Yara-5/DD2_Project_1/ai/mistakes_log.md

# AI mistakes log (overview, Appendix B)

| ID | Log entry | What was wrong | How you caught it | Would a weaker check have missed it? |
|---|---|---|---|---|
| M1 | U1 | The new `make check` piped the ngspice stress test through `tee`, so a stock ngspice (stress test exit 1) would still have passed `make check` | Re-reading the target: a pipeline's status is the last command's | Yes: on the fixed image the test passes either way, so only a stock build would show it |
| M2 | U1 | `transistor_level_check.py` passed the netlist and models as `DD2_Project_1/../student/...`; inside the container the repo is not mounted, so ngspice could not open them | `make sim` failed with "Could not find include file" | No: ngspice stops with a fatal error |
| M3 | U4 | The compact layout drew each signal pin shape flush with its 0.17 um li1 landing; Magic's resistance extraction starts a pin's net just outside the pin's lower-left corner, so it reported "Couldn't find wire" for A, B and Y and the RC netlist lost those nets' resistance | Tutorial 3's Magic error filter (the word "Error") made characterize.py stop on the generated nand2_1; LVS uses the same filter | Yes: a check that read only the netlist, without Magic's log, would have used an RC netlist with three nets unextracted |
| M4 | U4 | characterize.py ran six ngspice processes at once; the course ngspice evaluates BSIM4 with OpenMP threads set by its `num_threads` variable, not OMP_NUM_THREADS, so the runs oversubscribed the cores and a 20 s characterization took over 20 minutes | Load average 40 on 20 cores and 8 threads per ngspice (ps) | No check measures run time; fixed with `set num_threads=1` in every deck |
| M5 | U5 (review of fb7038d) | `src/netgen.sh` starts the container with `--entrypoint /usr/lib/netgen/tcl/netgenexec`; the course image (student pack `container/`) installs Netgen as `/usr/local/bin/netgen` and has no `/usr/lib/netgen`, so every LVS, RC-LVS and HD-LVS run fails (the script's own comment still describes the course image) | `make lvs`: all 18 cells `ERROR netgen exited with 127`; the log says `stat /usr/lib/netgen/tcl/netgenexec: no such file or directory` | Yes: `make test`'s LVS broken case (`nand2_1_wrong_width`) is still "rejected", only because Netgen never starts |
| M6 | U5 (review of fb7038d) | `euler.py` now looks the HD reference up in a fixed table `HD_SIGNAL_PINS` that leaves out nor3_1, so nor3_1 lost the `hd_reference` it had (its ports equal HD's), its LVS against HD and its Table 4 comparison | After `make layout`, `cells/dd2_g5__nor3_1/input.json` has no `hd_reference`; `make lvs` prints `HD-LVS=n/a` and `make compare` lists nor3_1 under `skipped_no_hd_reference` | Yes: no check requires a reference cell to have an HD reference; `compare_hd.py` skips such cells and still passes |
| M7 | U5 (review of fb7038d) | `verify_lvs.py` makes a cell fail unless LVS against the installed HD cell matches, and the change now gives a21o_1, mux2_1, a21oi_1 and o21ai_1 HD references. a21o_1 (12 transistors, HD 8) and mux2_1 (another topology) cannot match, and a21oi_1, o21ai_1 have the series order reversed (our PMOS B1 at VPWR, HD's at Y), which Netgen does not permute. `make lvs` fails for these four cells | `verify_lvs.py` run with the course-image Netgen wrapper (`--netgen`): LVS and RC-LVS match for 18/18, `HD-LVS=False` for the four, report `passed: false`, exit 1 | No: the check fails, once Netgen can run (M5 hid it) |
| M8 | U5 (review of fb7038d) | `hd_reference` maps the request's inputs to HD pin names by position (`zip(logical_inputs, hd_inputs)`) from a table keyed by the cell name, never from the function; it is right for the current requests only because they list inputs in HD order (mux2_1: A, B, C = A0, A1, S). `rename_layout_pins` is left commented out | Reading the diff; checked each mapping against the request's expression | Yes for the current requests; a request with its inputs in another order gets a wrong map and a false HD-LVS failure |
| M9 | U5 (review of fb7038d) | `validate_characterizer.py` (Table 5) is run by no `make` target, writes `results/characterizer_validation.json` outside `results/<check>/`, and its broken case (`characterize.py --index-by-ramp`) is not listed in `tests/broken/README.md` or run by `make test` (AGENTS.md rules 3 and 11); no stock-ngspice run exists, so the fixed/stock comparison of Table 5 has not been made | Reading the Makefile and `tests/broken/`; the checks were run by hand for this review | Yes: `make all` and `make test` pass without ever running the validation |
| M10 | U2 | `make network` pipes `synthesize.py` through `head -1`, so the shell sees `head`'s status and a crashed synthesis does not stop the loop | During this review's first `make layout`, `synthesize.py` raised `OSError` writing `cells/dd2_g5__maj4_1/network_schematic.png` (a locked file) and `make` went on to the next steps | Yes: the switch-level check that follows runs on whatever `network.json` is on disk |
| M11 | U6 | Fixing M7, `verify_lvs.py` was made to require LVS against HD only when the schematic is HD's circuit, so o21ai_1 (B1's PMOS 1.0 um, HD's 0.70 um) was only reported. Handout section 4.1 asks for the six reference cells "with the transistor sizes and pin names (A1, A2, B1 and so on) read from the installed cell's SPICE netlist", and Table 4 says the transistors "must match, including every W and L"; only a21o_1 and mux2_1 are report-only | Reading handout section 4.1 and Table 4 (U7) | Yes: `make test` passed with o21ai_1 reported |
| M12 | U5 | The review of fb7038d said there was no stock ngspice to run Table 5's simulator row with; Tutorial 3's image `dd2-layout-tools` has ngspice-42 (the handout names 42 as a stock build), and the course stress test fails on it (current ratio 1) | Listing the images and running `check_stress.sh` in each (U7) | Yes: `validate_characterizer.py` reported the stock build as NOT RUN, which is honest but was avoidable |
| M13 | U2 | The requests for handout Table 6 left out its last row, "One function of your choice" (17 functions plus inv_1 were in `tests/requests/`) | Re-reading Table 6 (U7) | Yes: no check counts the Table 6 requests |
| M14 | U7 | The first version of the disjoint decomposition in `synthesize.py` applied h's renaming of its internal nets to F's nets too, so F's stage `n1` became `x1_n1`, the name of one of h's stages: two stages drove one net in xor3_1. The built-in truth-table check passed, because it evaluates the stages in order and the second simply overwrote the first | The decomposition tree picture listed two stages `x1_n1` | Yes: the sanity check evaluated the function, not the connectivity; `synthesize.py` now refuses two stages on one net and nets shared between h and F |
| M15 | U7 | The rip-up-and-reroute router in `prepare_layout.py` checked a new via only against the fixed vias and, softly, other nets' vias: a net's own vias from its earlier connections, and two vias on one path, were never checked, so maj3_1 and xor3_1 got two vias of one net closer than mcon.2 allows (and overlapping cuts in xor3_1: mcon.1, li.1, met1.1) | `make test`: `verify_drc.py` failed every context of maj3_1 (2 errors, mcon.2) and xor3_1 (6-7 errors) | Yes: the cells were routed and drawn; only DRC stopped them. The router now treats the net's own vias as hard and repeats a search whose path puts two vias too close |
| M16 | U6 | Fixing M7, `euler.py` was made to pick the first placement whose circuit is exactly HD's (series order included). For nand2_1 and nand3_1 that placement does not route at HD's width, and `prepare_layout.py` widened it (a routing channel or an extra site) before trying the other placements, so both cells became one site wider than HD (4 and 5 sites); the README still said 3 and 4 | The Table 4 comparison of 6 November (`make reference`): `extra_sites: 1` for nand2_1 and nand3_1; the same in the 5 November log of U6 | Yes: width is a reported row of Table 4, so every check passed. `prepare_layout.py` now tries its attempts narrowest first; nand2_1 and nand3_1 are back to 3 and 4 sites with HD's series order |
| M17 | U7 | `compare_hd.py`'s new timing comparison required both cells to use the same table indices, but generated cells use HD nand2_1's indices and each installed cell its own, so the comparison raised an error as soon as a generated reference cell had been characterized | `make test` (`make reference`): `ValueError: ... use different table indices` | No: the check stopped with an error (exit 1). The generated tables are now interpolated bilinearly at the installed cell's points |
| M18 | U7 | Fixing M16, `prepare_layout.py`'s narrowest-first order put every attempt, li1 + met1 ones included, in one list sorted by width, so a multi-stage cell took a narrower route with met1 before a wider li1-only one: a21o_1 (5 sites, 6 vias) and and2_1 (4 sites, 6 vias) used met1 inside, and mux2_1 too. Handout Table 1 allows met1 in a multi-stage cell "only where li1 cannot route", and Table 4's wiring row ("li1 inside, met1 only for the rails") applies to a21o_1 and mux2_1 as well (only their transistor row is report-only) | `make test` (`make compare`): `met1_only_fixed_rails` failed for a21o_1 (0.6852 um2) and mux2_1 (0.4904 um2) | Yes: DRC, LVS and the simulations passed; only the Table 4 comparison stopped it. Every li1-only attempt (all widths, rip-up included) now comes before any li1 + met1 attempt; a21o_1 is li1-only at 6 sites (HD's width), and2_1 at 5 and mux2_1 at 10 (HD 9); the other 17 plans are unchanged |
| M19 | U8 | The first version of `liberty_view.py` required exactly one timing group per input, so the Liberty views of xor2_1, xor3_1 and mux2_1 (whose non-unate inputs have one positive_unate and one negative_unate group, as the HD Liberty writes xor2_1 and mux2_1's S) were rejected | Running the new check on all 20 characterized cells: `full_timing_tables` failed for xor3_1 ("A: 2 timing groups"); the HD Liberty then showed its own convention | No: the check rejected correct views; it now requires HD's two groups for a non-unate input and one group with the truth table's sense otherwise |
| M20 | U8 | `liberty_view.py` named its report `results/views/dd2_g5__<cell>.json` while `write_response.py` reads `results/views/<cell>.json`, as every other report is named | The first response of f14_1 said status "fail", reason "Liberty view: not run" | No: the response failed instead of passing; the report now uses the short name |
| M21 | U10 | The first met1 version of `folded_finger_nets_on_met1` started each new connection of a net from its li1 points only, so where the net's via already sat on a landing, the next connection put a second via an mcon pitch away, joined by an li1 jog (Y in nor3_stack_1: vias at 2.09 and 2.45 um) | The user, looking at the layout picture ("what are those two contacts in the middle?") | No check: the cell passed DRC, LVS and simulation; connections of the policy's nets now start from every point the net reaches, met1 included |
| M22 | U10 | Fixing M21, the record of the policy nets' met1 points was not reset between the router's net orders, so a later order branched from met1 wire that only an earlier order had laid; that attempt had the fewest vias and was kept, with Y and Y_u1 open | Reading the plan's routes before drawing: vias without met1 wire between them | Yes, before any check ran (LVS would have failed); the record is now cleared with the rest of each order's state |
| M23 | U12 | `multiply_cuts` (and `stack_contacts`) measured the gap between two diagonal shapes as the Euclidean distance, but Magic checks li.3 with square corners: a new licon column's li1 in a21oi_1 sat 0.07 um (x) and 0.16 um (y) from an A2 gate landing, 0.175 um diagonally, accepted | `verify_drc.py` on the sample: a21oi_1, 3 li.3 errors in each of its 24 contexts | Yes: DRC failed (exit 1); both functions now take the larger of the x and y gaps, as the router's rasters do; a21oi_1 then passed |
| M24 | U13 | The parallel defaults (JOBS 4 x INNER_JOBS 4 = 16 ngspice runs at once) were chosen from the core count, with memory named but not measured: 16 sky130 ngspice runs (about 0.4 GB each) do not fit in the 7.7 GB WSL memory | The full run of 10 November: the transistor-level step took 4 hours under swapping, and `make char` failed: f14_1 and f15_1 characterized 0 arcs (ngspice exit 137, killed by the kernel) | Yes: `characterize.py` exited non-zero and `make char` stopped (exit 2); measured 4, 8 and 16 runs at once (36 s, 40 s, 461 s) and set INNER_JOBS to 2 (8 at once) |
| M25 | U12 | `multiply_cuts` grew mcon arrays from every via in all four directions, adding li1 and met1 bars just to hold them: xor3_1 got three mcons in a row along x1's met1 wire and two along n1's, which carry next to no current and take room; and nothing kept other nets' met1 away from the pins (n1's met1 ran beside the Y pin), so a router placing the cell could not reach some pins on met1 | The group's review of xor3_1's preview on 11 November (no check covers either: DRC, LVS and the simulations passed) | No (caught by review): arrays now only along a stacked licon column; pin access pads reserved in the router and checked after planning (`check_pin_access`); 13 blocked pins in the five met1 cells, now none |
| M26 | U16 | `route_negotiated` let a wire end anywhere inside a fixed gate landing; in nor4_stack_1 two wires and their gate landings overlapped only corner to corner (0.09 x 0.09 um), a diagonal neck of 0.13 um, narrower than li.1 (0.17 um) | `verify_drc.py`: 2 li.1 errors in each of nor4_stack_1's 24 contexts; KLayout's width check placed both at the wire-landing corners | Yes: the planner's own checks measured spacing only, and LVS and the simulations do not see width; now a wire joins a fixed landing on its centre line, and `fill_notches` checks every merged net's width |
| M27 | U16-U19 | The scratch benchmark that plans many cells at once was meant to read regenerated layout specs from a folder named in ROOT, but the patch that added ROOT never applied (a shell heredoc handed Windows Python a path it could not open, and its error went unread). Every run that set ROOT planned the old specs from cells/ and build/stack instead: the same-gate placements of section 8.8 (xor2_1, xor3_1, nor4_stack_1) and the unsplit covers of section 8.7 were never planned, and the sizing run planned the x1 networks. The docs then credited the unsplit covers with a21oi_stack_1 and nand2_stack_1 losing their met1 (the wide landings did it) and said xor2_1's and xor3_1's new placements did not route (untested) | Reading the sizing run's output: it listed 27 cells planned, not the 8 under ROOT | Yes: every planned layout was legal and passed DRC and LVS, so no check could see that the wrong input had been planned; the benchmark now prints the spec folder of every cell and stops when ROOT matches none |
| M28 | U18-U20 | The cap on the negotiated router's failures per placement (2) assumed that a placement failing twice fails at every width; it was checked only on xor3_1, where it held. nor4_stack_1 and o21ai_stack_1 succeed on their third negotiated attempt or later, at another routing channel, so with the cap they came out 11 sites, and 10 sites with met1, instead of 10 and 8 on li1 | The all-cell planner benchmark of the runtime changes, compared cell by cell with the latest known results | Yes: both layouts were legal, so DRC and LVS would have passed them; only comparing widths and vias with earlier runs showed the loss. The cap was removed |
| M29 | U19 | The opt sizing searched internal widths from channel_min_width (0.36 um), taken for the smallest legal transistor. The installed sky130A.tech checks standard FETs against 0.42 um (diff/tap.2, allfetsstd) and extracts any narrower one as sky130_fd_pr__special_nfet_01v8 / special_pfet_01v8_hvt; 0.36 um applies only to those special devices. mux2_opt_1 (input inverter 0.36/0.36 um) and xor3_opt_1 (two stages at 0.36 um) were extracted with special devices that the schematic does not have | verify_lvs.py in the three-family run of 10 November: LVS and RC-LVS failed on both (device classes differ); Netgen's report named the special FETs | No: LVS caught it. Fixed with a rule fet_min_width (0.42, proven by make check against line 4771 of sky130A.tech) as the opt minimum |
| M30 | U20-U22 | The final three-family run chained `make test_views` after the checks, assuming that its prerequisites (roundtrip, views) pulled in characterization; `views` has no prerequisite on `char` (the order is documented, not enforced), so characterization never ran and the Liberty views were built from characterized.json files written before the layouts changed | `liberty_view.py` in that run: a21oi_1 failed `area_is_the_layout` (stale characterization, old area) and the new stack and opt cells stopped on a missing characterized.json; `make views` exited 2 | No: the check refused stale and missing data, so nothing wrong was written; the run was restarted as `make char views roundtrip test_views` in that order |
| M31 | U24 | To check the merged Makefile, `make -n check` was run in the repository itself. A dry run still executes every recipe line that contains `$(MAKE)`, and Yara's stress-test line did (its rebuild branch), so the stress test ran with the Windows-path mount and wrote Docker's error to results/check/ngspice_stress.log; the broken log was committed in 97afe2d | `liberty_view.py` in the first `make demo` runs: "the ngspice stress test did not pass" for both cells | No: the views check refused the log, so no Liberty view was written from it; `make check` (fixed) regenerated it, identical to the full run's log (ngspice-47, SHA 51123371..., ratio 1.035) |
