Yara-5/DD2_Project_1/ai/use_log.md

# AI use log (overview, Appendix B)

Every session ran in Claude Code on Youssef's PC, which the group shared, so the assistant's environment always shows Youssef. **Who** names the member whose part the session worked on: Youssef Ayman Hassan the synthesizer and layout optimizations, Hassan Ashraf the Euler paths and routing, Yara Abdelkader the characterizer, the request reader and testing. A session that touched more than one part names each owner.

| ID | Date | Who | Tool and model | What you asked | What you kept or changed | How you checked it | Commit |
|---|---|---|---|---|---|---|---|
| U25 | 2026-11-11 | Yara | Claude Code, Claude Opus 5.5 | "fix the issues with the demo" | Makefile `demo` rewritten as `demo` + `demo-cell`: every file goes to build/demo/ (cells/<name>/, results/<check>/), so a demo no longer overwrites the committed cells/ and results/; the transistor-level check reads the netlist verify_lvs.py just extracted (before, cells/<name>/ held none for a new cell, or an old one); synthesize.py gets --hd-liberty (opt sizing); characterization runs only when Table 5 has passed and the stress log exists; the HD comparison and the round trip are added. src/request_reader.py: the request is no longer renamed after its file (Yara's cb80672); its own "name" is validated as before, so the GUI's request_raw.json no longer becomes dd2_g5__request_raw. A refused request still gets a fail response; the demo now exits non-zero for it. The HD comparison runs only for a request with an installed HD counterpart (compare_hd.py fails with no cell to compare) | `make demo` on a new function from a file named differently (build/demo_input/interview_request.json, name dd2_g5__o21a_1): every step passed, response "pass" (2 stages, 8 transistors, 6 sites, DRC 0 in 24 contexts, LVS and RC-LVS match), round trip equivalent, exit 0 in 201 s; on tests/requests/nand2_1.json: every step including LVS against HD and the HD comparison, exit 0; on tests/broken/bad_request.json: fail response with the reader's reason, exit 2; git status showed no change under cells/ or results/ from any demo | (uncommitted) |
| U24 | 2026-11-11 | Yara | Claude Code, Claude Opus 5.5 | "I want you to verify that the portability stuff are working properly", then "Yes, fix them" | Makefile (`make check`, `docker-stock-image`), on top of cb80672: the HD Liberty is tested at its host path (HD_LIB_HOST); the tool checks run `command -v` inside `sh -c`, since `wsl -e` starts programs only; the stress test folder is mounted by its Linux path; after a stock ngspice (check_stress.sh exit 1) is rebuilt, the second run is written to results/check/ngspice_stress.log and sets the exit status (before, the log kept the stock FAIL while make check passed); the stock image is built as ngspice 42, Tutorial 3's stock version, not an unpatched 47. No check got weaker; the stress test itself is unchanged | In a worktree of main on Windows + WSL: unfixed, `make check` failed on the HD_LIB test, the tool tests and the Docker mount; fixed, `make check` exit 0 (stress PASS, ngspice-47); `make check IMAGE=<copy of Tutorial 3's stock image>` detected ngspice-42 (FAIL), rebuilt the image, retested it (PASS, ngspice-47) and wrote that second run to the log, exit 0; `make docker-stock-image` built ngspice-42, whose stress test reports stock (exit 1). Table 5 was not rerun with the newly built stock image | (uncommitted) |
| U23 | 2026-11-11 | Yara, Youssef | Claude Code, Claude Opus 5.5 | "run the whole flow for the 3 families" (finished), then "Yes, update docs" after the opt cells were characterized | Ran the three-family flow on 33 cells (xor3_opt_1 held out on "Drop it, run the rest"); README results and limitations and docs/TECHNICAL.md 7.1, 19.2-19.3, 20 rewritten from the result files: opt measured against hd (maj4 -5.3 %, and2 +34.4 %), so the Elmore model's predicted gains are reported as not confirmed | `make drc lvs compare sim model`, `make -o all test`, `make char`, `make views`, `make roundtrip`, `make test_views`: all exit 0 (logs build/full_nov10e, build/full_nov10f); every number in the docs read from results/ and cells/ | (uncommitted) |
| U21 | 2026-11-10 | Yara | Claude Code, Claude Opus 5.5 | "Let's speed-up the transistor-level check. It's insane if it's 4 hours." Check script changed on this explicit request (AGENTS.md rule 9) | src/transistor_level_check.py: every DC row and every edge becomes its own copy of the cell (own sources, own load, sharing only the ideal supply) in one netlist; the copies run in --jobs decks, one ngspice run each (op for the DC rows, tran for the edges), instead of one ngspice run per case. Cases, transient timing, thresholds and verdict code unchanged (not weaker); docs/TECHNICAL.md 12.2, README | Against the 10 November reports on the same netlists, case by case: nand2_1, a22oi_1, xor3_1 identical verdicts, DC voltages and worst glitches (0.000 uV / 0.000 mV apart), 20-28 s per cell; broken case nand2_1_pex_missing_pullup still rejected (exit 1) on the same DC row and the same 3 edges; a missing model file still fails (exit 1); original kept in build/ for the comparison | (uncommitted) |
| U20 | 2026-11-10 | Hassan | Claude Code, Claude Opus 5.5 | "how can we address 7" (runtime), "let's go", then "make the call now, we don't have time really" | prepare_layout.py: rip-up skipped in the li1-only attempts when the negotiated router runs (policy rip_up_with_negotiated, false); quick check that routes every net alone with movable contacts before an li1-only attempt (policy lone_net_check, `route_negotiated(first_pass_only=True)`); the per-placement cap on negotiated failures (added the same day for xor3_1) removed; rules.json, docs/TECHNICAL.md 9.6, README limitations | Planner-only re-plan of all 27 cells: 25 unchanged and the met1 cells 2-3x faster; nor4_stack_1 and o21ai_stack_1 regressed, traced to the cap (mistakes log M28); re-planned without it, both back to 10 and 8 sites on li1; xor3_1 not re-timed without the cap; no DRC or LVS needed for unchanged layouts | (uncommitted) |
| U19 | 2026-11-10 | Youssef | Claude Code, Claude Opus 5.5 | "Do option 2, we're going all in" (a sizing method of our own), then "Document this sizing method and explain the elmore delay estimation in the technical.md" | synthesize.py: `inverter_model` (RC per um fitted to HD inv_1's Liberty), `worst_delay` (Elmore, every pin, edge and route), `size_internal_stages` (coordinate descent over internal stage widths), `--hd-liberty`, `--rules`; rules.json policy internal_stage_sizing; docs/TECHNICAL.md 7.1, README item 10. The Makefile is unchanged: the handout's hd and stack ways keep inner stages x1, so the method is an optional third way until the group decides | Model widths and predicted delays for 8 multi-stage cells (network.json in build/size); switch-level check PASS on all 8; widths in sites unchanged; verify_drc on all 8 in build/sizechk and build/sizechk2: 192 contexts 0 errors, control caught, layer check PASS; no characterization yet (planned for the end of the day), so the gains are predictions | (uncommitted) |
| U18 | 2026-11-10 | Hassan | Claude Code, Claude Opus 5.5 | "next weakness" (pins for place and route), then "undo this. I think it's not necessary. Go and consider weakness 4" (folded layouts) | Pin patches on met1 tracks (planned, sampled with DRC and LVS) removed again at the group's request: nothing of them is left in src/ or rules.json. euler.py: `finger_cover(unsplit_first)`, `stage_options` keeps the two best covers with the fewest split leaves, `build_layout_spec` accepts any placement with the same devices as an alternative; docs/TECHNICAL.md 8.7 and 9.8, README item 9 | All 27 specs regenerated: first placements and devices unchanged; a first planner benchmark meant to use them planned the old specs (mistakes log M27): its a21oi_stack_1 and nand2_stack_1 gains (li1 only) came from U17's wide landings. Re-planned from the regenerated specs: a22oi_stack_1 13 sites and 9 vias -> 10 sites li1 only (build/chk5: DRC 24 contexts 0 errors, layer check, LVS and RC-LVS match), xor3_1 16 -> 14 sites (13 vias), xor2_1, nor4_stack_1, nand3_stack_1, nor3_stack_1, o21ai_1 unchanged; policy negotiation_failures_per_placement added (xor3_1 over 40 CPU minutes -> about 14 minutes), removed again in U20 (mistakes log M28); in build/chk4 verify_drc: 48 contexts 0 errors, control caught, layer check PASS; verify_lvs: LVS and RC-LVS match; transistor-level check not run; cells/ and results/ not rebuilt | (uncommitted) |
| U17 | 2026-11-10 | Hassan | Claude Code, Claude Opus 5.5 | "let's consider the second weakness now" (cells wider than HD) | prepare_layout.py `route_negotiated`: a movable contact's landing may be wide (0.33 x 0.17 um) as well as tall, whichever is legal and less crowded; docs/TECHNICAL.md 9.5e and 9.8, README item 7 and limitations | Widths against HD's prBoundary and against each cell's narrowest placement (every extra site came from routing); planner benchmark of the 13 cells whose routing cost width: o22ai_1 7 -> 5, nand3_stack_1 15 -> 10 and o21ai_stack_1 10 -> 8 without met1, nor4_stack_1 10, a21oi_1 4, eight unchanged; in build/chk2 verify_drc: 120 contexts 0 errors, control caught, layer check PASS, 20 broken layer copies rejected; verify_lvs: LVS and RC-LVS match on all five, LVS against HD a21oi_1 match; transistor-level check not run; cells/ and results/ not rebuilt | (uncommitted) |
| U16 | 2026-11-10 | Hassan | Claude Code, Claude Opus 5.5 | "List the weaknesses we have now... We want to highly improve this cell generator", then "Yes, router first", "I don't want you to re-run the whole flow after improving each weakness... choose only what's absolutely necessary", "let's document this behavior" | prepare_layout.py: `route_negotiated` (li1 router with negotiated congestion that places the signal diffusion contacts; tried after the fixed-landing router at each li1-only width), `plan_geometry(movable=)`, output pin placed after routing, `gate_runs(any_gate=)`, width check in `fill_notches`; euler.py `place_stages` keeps up to 8 more placements with adjacent same-gate columns; rules.json policies negotiated_router, negotiation_*, poly_bars_same_gate (all on); docs/TECHNICAL.md 8.8, 9.4, 9.5e, 9.6, 9.8, README items 7-8 and limitations | Planner benchmark of all 27 cells (20 requests and 7 stack cells) in build/, no simulation: a21oi_1 5 -> 4 sites, nor4_stack_1 5 vias -> li1 only at 11 sites, 25 unchanged; DRC in build/chk failed first on nor4_stack_1 (li.1, M26), then after the fix: 48 contexts 0 errors, control caught, layer check PASS, LVS and RC-LVS match, LVS against HD a21oi_1 match; transistor-level check not run; cells/ and results/ not rebuilt | (uncommitted) |
| U15 | 2026-11-11 | Youssef, Hassan | Claude Code, Claude Opus 5.5 | "having 3 mcons horizontal like what we have on the top left here is meaningless. Same for the two below. Also there is a metal1 wire passing too close to the Y pin. These pins will need to access met1 later (Y pin and input pins)" (on xor3_1's preview) | prepare_layout.py: `via_pad`, `pin_access_pads`, `check_pin_access`, `square_gap`; router treats each signal pin's met1 access pad as met1 of its net; planner tries every pin reachable, then one pin per port, per attempt; output pin on the first landing whose pad clears the rails; `multiply_cuts` mcon arrays only along the licon column a via is stacked on (spanning the via, no li1 added, met1 bar clear of other nets and pin pads); rules.json policy pin_access_met1 (true), description; docs/TECHNICAL.md 9.5c, 9.5d, 9.8, README | Five met1 cells re-planned in build/pa: pins blocked 13 of 32 -> 0; arrays none (no room beside any stacked column); maj3_1 10 -> 12 sites, maj4n_1 7 -> 10, maj4_1, xor2_1, xor3_1 unchanged; verify_drc: 120 contexts 0 errors, control caught, layer check PASS; verify_lvs: LVS and RC-LVS match, isolated DRC unchanged (tap rules only); transistor_level_check PASS for all five (DC and every single-input edge); the other 15 cells re-planned in build/pa15: shapes identical to cells/ | (uncommitted) |
| U14 | 2026-11-10 | Yara | Claude Code, Claude Opus 5.5 | "After that run the whole flow with the current optimizations and review the results" (same request as U13) | Makefile: per-cell steps run again on a Windows file lock (Errno 22 or 13 only, 3 tries, logged in build/logs/); INNER_JOBS 4 -> 2 after the run (M24); README sections 3, 5, 6, 9 and docs/TECHNICAL.md 2.4, 19.2-19.4, 20 updated from the run's files; a stray results/transistor_level/nonexistent.json (from testing the retry) deleted (rule 11) | make check exit 0 (4 s); make test exit 0 (4 h 22 min: every check passes for all 20 cells, all 10 broken cases rejected); make char at 16 ngspice runs at once exit 2 (f14_1, f15_1 killed out of memory); measured 4/8/16 runs at once (36/40/461 s), INNER_JOBS 2; make char exit 0 (45.6 min, memory peak 6.9 GB of 7.7), make test_views exit 0 (1.9 min, one file-lock retry, views-nand2_1). Review: 130 sites (138), 348 diffusion licons (190), 37 vias (60), summed R -10 to -47 %, C +3.6 to +17 % (two narrower cells lower), median delay -3.9 to +0.4 %; HD timing within 2.9 % for the seven single-stage cells, a21o_1 +5.3 % (+10.2 %); NOR3 stack 2.5 x area (3.75 x) | (uncommitted) |
| U13 | 2026-11-10 | Yara | Claude Code, Claude Opus 5.5 | "When you finish this, parallelize the flow, document the decisions you make, I will not be available to answer them. After that run the whole flow with the current optimizations and review the results." Check scripts changed on this explicit request (the earlier proposal named verify_drc.py, verify_lvs.py and the simulation scripts; AGENTS.md rule 9): only how they run, not what they check | Makefile: JOBS (4) and INNER_JOBS (4); per-cell targets network-, layout-, sim-, model-, charhd-, char-, views- run by a sub-make -j$(JOBS) -Otarget; drc, lvs and reference pass --jobs; magic_drc_runner.py and verify_drc.py: --jobs, DRC contexts on a worker pool, results in manifest order; verify_lvs.py: --jobs, cells on a worker pool, results in name order; README, docs/TECHNICAL.md 2.4 (the five decisions) | verify_drc.py --jobs 4 on a21oi_1 (24 contexts, 12 s): every field equal to the serial report but the context GDS hashes (time-stamped by KLayout on every run); verify_lvs.py --jobs 4 on five cells: report identical; make layout on inv_1, nand2_1, a21oi_1 in parallel (9 s): same shapes as the serial runs. The full make test / make char / make test_views follows (row U14) | (uncommitted) |
| U12 | 2026-11-10 | Youssef | Claude Code, Claude Opus 5.5 | "whenever we place licon, maximize the number of licons placed in parallel... Similarly, when you place the met1 vias, maximize their number"; answers asked for: fill after routing; signal and supply diffusion contacts and met1 vias (not gate contacts); arrays at each via point; verify a sample now | rules.json: licon_space (0.17, licon.2, proven by `make check`: 30 rules), policies multiple_licons and mcon_arrays (default true); prepare_layout.py: multiply_cuts (largest licon column per diffusion contact, narrow or wide li1 bar; mcon arrays grown breadth first), supply contacts record their y range, square-corner spacing in multiply_cuts and stack_contacts (M23); docs/TECHNICAL.md 9.5c, 9.8, README | Sample in build/mc, build/mc3: inv_1, nand2_1, a21oi_1, maj3_1, xor3_1 re-planned (widths unchanged; licons 4->9, 5->12, 7->13, 14->26, 22->45; mcons 9->10, 10->14); verify_drc: four cells 0 errors, a21oi_1 72 (li.3, M23), after the fix 0, control caught, layer check PASS; verify_lvs: LVS, RC-LVS and HD-LVS match; transistor_level_check PASS for all five; extracted R -9.5 to -27.8 %, C +7 to +17 % | (uncommitted) |
| U11 | 2026-11-10 | Youssef | Claude Code, Claude Opus 5.5 | "In general, I want to minimize the length of the path that uses li1 if it is going to connect to met1 anyway. I want the contact and via to be aligned directly on top of each other whenever possible... Don't forget to document all the optimizations we'll do in this session." | prepare_layout.py: stack_contacts (a diffusion contact joined to a via of its net by one straight vertical li1 stub moves under the via when its licon.5c range and li.3 allow; contacts record y_range_um and landing_box), policy stack_contacts_under_vias (default true); a connection that needs met1 pays met1_route_li1_step_cost (100, replaces folded_finger_li1_step_cost) per li1 step and may start from the net's met1 wire (multi-source search), for every net, not only the policy's; rules.json: the two policies; cells/ of maj3_1, maj4_1, maj4n_1, xor2_1, xor3_1 replaced by the checked layouts; README (Layout optimizations, Limitations), docs/TECHNICAL.md 9.5, 9.5a, 9.5b, 9.8, 19.3 | Re-planned the six cells with vias (build/stack_try2): vias on a contact 6 -> 37 of 46, li1 in met1-carrying nets -37 % to -82 %, maj3_1 12 -> 9 vias, xor3_1 14 -> 10, maj4n_1 10 -> 7 sites. In build/verify_stack: verify_drc 144 contexts 0 errors, control caught, layer check PASS; verify_lvs LVS and RC-LVS match for all six; transistor_level_check PASS for all six. Signal-net R (sum of extracted resistors) -1.0 % to -8.1 %, C -3.1 % to +11.6 %. Not run: the full flow; the six cells' reports in results/, their characterization, views and responses are still those of the 6-7 November layouts | (uncommitted) |
| U10 | 2026-11-10 | Youssef, Hassan | Claude Code, Claude Opus 5.5 | "For the transistor folding... connect the polys directly without using li1 or met1. Try doing this. Do not run the whole flow, only what's essential"; clarified: "you only need to extend the spacing between consecutive polys to space out the transistors"; then: route folded fingers' nets on met1 instead of li1, chosen as a switchable policy (asked, because handout Tables 1 and 3 keep met1 for the rails in single-stage cells) | euler.py: finger_cover prefers each leaf's fingers side by side (new cost term after width), so the narrower row's gates spread out under their fingers; prepare_layout.py: gate_runs, one poly bar per run in the npc band with one contact, no pad or li1 bound for contact-less fingers (pitch 0.42 um); policy folded_finger_nets_on_met1 (rules.json, default false) with folded_finger_li1_step_cost, multi-source search from the net's met1 wire, `--policy NAME=JSON` override; docs/TECHNICAL.md sections 8.7, 9.4, 9.5, 19, 20, README | Local work stashed (stash@{0}) and `git pull`: origin had nothing new. Only nor3_stack_1 rebuilt (cells/): euler.py, switch level PASS, prepare_layout (1 s, was 1226 s), generate_gds: 10 sites (was 15), 0 vias (was 16), 3 gate contacts (was 9); in build/stack_only: verify_drc 24 contexts 0 errors, control caught, layer check PASS; verify_lvs LVS and RC-LVS match; transistor level 8 DC rows, 24 edges PASS. Re-planned nand2_1, a21oi_1, a21o_1, o22ai_1, f15_1 into build/: geometry identical. Policy on (build/met1_variant2): 10 sites, 9 vias, DRC 0, LVS/RC-LVS match, simulation PASS; Y R -12.7 %, C +7.6 %. `make check` PASS (29 rules). Not run: the full flow; nor3_stack_1's DRC/LVS/sim reports in results/ and its characterization, views, response and sizing comparison are still those of the 15-site layout | (uncommitted) |
| U8 | 2026-11-07 | Yara | Claude Code, Claude Opus 5.5 | "Do 1 to 3 as you suggested. Go back to the project handout and make sure you know all the details. You also mentioned that AGENTS.md is outdated. Fix that first before doing anything else." Items 1-3: the final Liberty view per cell with the model-level check on it, the response writer, the round trip of section 3.3. The model-level check changed on this request (item 1 said it must run on the final Liberty), more general only (AGENTS.md rule 9) | AGENTS.md: current state, check table (`make reference`, `char_validate`, `char`, `views`, `roundtrip`, `test_views`), image names, port naming (to be committed on its own, as AGENTS.md asks); new liberty_view.py (checks characterized.lib against the request, the layout and the stress-tested ngspice before writing cell.lib; merges libs/dd2_g5__tt_025C_1v80.lib); model_level_check.py: `--liberty` checks the characterized view, the function-only Liberty is now functional.lib (it no longer overwrites cell.lib), quoted pin names accepted; new write_response.py (Appendix A response, refused requests included, and report.json); new round_trip.py (each cell inside hd_reduced.lib, map.sh's commands and scripts A and B read at run time, each ABC script passed as a file because Yosys 0.52 splits map.sh's inline script and map.sh then maps nothing and exits 0, ABC cec with our cell as its Verilog model, use of our cell required where hd_reduced.lib has no cell with the function); characterize.py: operating_conditions group written before default_operating_conditions (OpenSTA warning; no number changes, takes effect at the next `make char`); Makefile: `views`, `roundtrip`, `test_views`; `make network` writes a refused request's response; new broken cases nand2_1_missing_arc.lib, nand2_1_wrong_function.lib, f14_1_wrong_function.lib; tests/broken/README.md, README, docs/TECHNICAL.md (sections 2.3, 13.8, 18, 21) | `make test_views` exit 0 (build/m3_views.log, 1 min 8 s, on the cells of the 6-7 November run): 20/20 Liberty views pass, 20/20 model-level checks on the characterized Liberty, 20/20 responses "pass", merged library of 20 cells loads in Yosys and OpenSTA; round trip 20/20 (cec equivalent for both scripts on every cell; our cell required and used for f14_1, f15_1, maj4_1, maj4n_1; used by at least one script for 13 cells); the three broken cases rejected for the intended reason (missing arc of B; function 0x1 against 0x7; cec counterexample D=1 C=1 A=1 B=0). A 5-input request gave a "fail" response with the reader's message. The first `make test_views` stopped on a transient Windows lock (Errno 22) of results/model_level/o22ai_1.json; no file was open, the rerun passed. Not run: the full `make test`/`make char` after these changes | (uncommitted) |
| U7 | 2026-11-07 | Youssef, Hassan, Yara | Claude Code, Claude Opus 5.5 | "Go through the project handout again ... do all the changes required to have milestone 2 complete (this includes taking the measurements from sky130 for the reference cells, the stack method implementation, and other things you might find are missing) ... report everything you've done"; decisions asked and answered: OpenSTA installed by the user, objective fewest transistors, own Table 6 function A ^ B ^ C. Check scripts changed on this explicit request, only stricter or more general (AGENTS.md rule 9) | Makefile: `make reference` (the six section 4.1 cells built and checked alone, first stage of `make all`), `make char` characterizes all generated cells and the installed nor3_1/a21o_1/mux2_1, then sizing and comparison; new reference_cell.py (reference requests take HD's pin names and transistor sizes from the installed SPICE netlist, handout 4.1; fixes M11); synthesize.py: objective fewest transistors (no longer fewest inverters), sizes per device from the installed cell, Ashenhurst disjoint decomposition (synthesize_best; xor3_1 20 transistors), refuses two stages on one net (M14); euler.py: folding of wide devices into fingers ('stack' sizing), HD placement order; prepare_layout.py: folded fingers and stepped diffusion, rip-up and reroute (rules.json policies rip_up_limit, rip_up_penalty), own-net via spacing (M15), attempts narrowest first (M16), li1-only attempts before any met1 attempt (M18); characterize.py: settling window doubled up to 64 ns when an edge does not settle (recorded as extended_windows_ns), negative delays allowed down to the input ramp's threshold crossing, installed cells' RC netlists kept for the parasitics comparison; verify_lvs.py: LVS against HD required for the six section 4.1 cells (hd_reference.MUST_MATCH; stricter); compare_hd.py: Table 4 pins row (pass/fail; more general), parasitics (R and C per port) and timing (bilinear interpolation at the installed cell's points, M17) reported; validate_characterizer.py: Table 5 design-level row via new design_level.py (Tutorial 4's synth.ys on SPM, OpenSTA); new compare_sizing.py (hd against stack on NOR3); new requests xor3_1 (Table 6 "one function of your choice", M13) and nor3_stack_1; new broken cases a21oi_1_swapped_hd_pins.json and pins/dd2_g5__inv_1_pin_off_band; .gitignore: .history_sta; README and docs/TECHNICAL.md (sections 6.9, 9.5, 9.6, 13.3, 13.7, 14, 19, 20, 21) updated | Last run 6-7 November: `make check` exit 0 (29/29 rules, stress test PASS 1.035); `make test` exit 0 (build/m2_test5.log, 1 h 58 min): reference stage pass, switch level 20/20, DRC 480 contexts 0 errors plus the control, layer check with 80 derived cases, LVS and RC-LVS 20/20, HD-LVS required and matching for inv_1, nand2_1, nor2_1, nand3_1, nor3_1, a21oi_1, o21ai_1, reported for a21o_1 and mux2_1, compare (frame, pins, wiring) PASS for 9 cells, transistor and model level 20/20, all 10 broken cases rejected; `make char` exit 0 (build/m2_char5.log, 53 min): Table 5 PASS (median 3.36 % fixed, 4.83 % stock, caps 5.5 %, Yosys and OpenSTA load, SPM +0.10 %, broken case 7.46 % flagged), all 20 generated cells characterized, sizing comparison written. Earlier runs stopped on M15, M16, M17, M18 and on a Windows file lock (Errno 22: a picture under cells/ open in a viewer) | (uncommitted) |
| U6 | 2026-11-04 | Yara | Claude Code, Claude Opus 5.5 | Fix the mistakes M5-M10 found in the review of fb7038d ("Yes, fix them"; check scripts changed on this explicit request, AGENTS.md rule 9) | netgen.sh: entrypoint `netgen` (course image), overridable by NETGEN_ENTRYPOINT in local.mk (M5); new hd_reference.py: the reference cells, HD's ports and function from the Liberty, every pin map under which HD's function equals the request's truth table, and an exact circuit comparison (W/L included) (M6, M8); euler.py: uses it, prefers the map that keeps pin names and, among equal-cost placements, HD's series order; verify_lvs.py: re-derives the valid maps and rejects a spec whose map is not one of them (stricter), renames schematic and layout to HD's pins, requires LVS against HD when the schematic is HD's circuit and reports it with transistor counts otherwise (M7); validate_characterizer.py: every Table 5 part required, a part that did not run is reported NOT RUN and fails the check (stricter), report in results/characterization/; Makefile: `make char_validate` (broken full-ramp run, optional STOCK_IMAGE run, Yosys/OpenSTA syntax), `make char` after it, `make network` keeps synthesize.py's exit status (M9, M10); new broken case a21oi_1_wrong_pin_map.json with merge_json.py; tests/broken/README.md, README, docs/TECHNICAL.md updated | `make test` exit 0 (build/fix_test4.log): network, layout, DRC (432 contexts, layer check), LVS and RC-LVS 18/18, HD-LVS required and matching for inv_1, nand2_1, nor2_1, nand3_1, nor3_1, a21oi_1, reported for a21o_1 (12 vs 8), mux2_1 (12 vs 12), o21ai_1 (6 vs 6, B1 PMOS 1.0 against 0.70 um); compare PASS for 9 cells; transistor and model level 18/18; all 8 broken cases rejected, the two LVS ones for the right reason (width mismatch; invalid pin map). `make char_validate` FAIL: fixed ngspice median 3.36 %, caps within 5.5 %, full-ramp case flagged (7.46 %), Yosys loads the six .lib files; NOT RUN stock ngspice (no image) and OpenSTA (not installed). Two earlier `make test` runs stopped on transient Windows file errors (Errno 22). Open: handout 4.1 requires o21ai_1 to match HD with sizes from the installed netlist; not done (left as is on request) | (uncommitted) |
| U5 | 2026-11-04 | Yara | Claude Code, Claude Opus 5.5 | Review and verify commit fb7038d (HD pin names, characterizer validation); log its mistakes; say whether milestone 2 is complete | No code changed; mistakes M5-M10 logged | `make layout`, `make compare` (pass, 8 cells); `verify_lvs.py` with the pushed `netgen.sh` (all 18 fail, exit 127) and with e26274a's wrapper via `--netgen` (LVS, RC-LVS 18/18, HD-LVS fails for a21o_1, a21oi_1, mux2_1, o21ai_1, exit 1); `validate_characterizer.py` on `make char_hd`'s results (median 3.36 %, caps within 5.5 %, PASS) and with the `--index-by-ramp` broken case (median 7.46 %, flagged); Yosys `read_liberty` on the six .lib files (pass). Not run: stock ngspice (no image), OpenSTA (not installed), `make test`, `make drc sim model` | (uncommitted) |
| U4 | 2026-11-02 | Hassan, Yara | Claude Code, Claude Opus 5.5 | M2 items 2 and 3 of docs/TECHNICAL.md: narrower li1-only cells, and the characterizer of section 5 | prepare_layout.py: the frame's npc band over the whole cell, directional 0.17 x 0.33 landings, poly contacts beside their gates chosen by a dynamic program over per-gap pitches, half-rule cell edges, supply contacts merged into the rails, rail-side PMOS landings, a 0.01 um byte-grid router; euler.py: a supply contact between two appearances of a net no longer counts as a blocker; rules.json: licon.5a, licon.8, poly.4, licon.14, licon.9 + psdm.5a added (proven by pdk_rules.py); new characterize.py (Magic extraction, SA/SB from the .ext positions and the GDS, slowest side inputs, capacitance over the input ramp, Liberty with the ngspice version and SHA-256); `make char_hd`, `make char`. No check script changed | `make check` (29/29 rules proven, stress test PASS); `make -k layout drc lvs compare sim model` on all 18 requests, exit 0 (432 DRC contexts clean, broken context caught, 72 broken layer copies rejected, LVS/RC-LVS 18/18, transistor and model level 18/18); `make char_hd` 6/6, compared with the shipped Liberty by a scratch script (docs/TECHNICAL.md 13.6). `make test` not run | (uncommitted) |
| U3 | 2026-10-30 | Hassan | Claude Code, Claude Opus 5.5 | Euler paths for every stage in a format the layout step reads, so any function reaches GDS; use Maziasz & Hayes (DAC 1991) where it helps, cited in code | Added euler.py (series reordering, exact minimum dual-trail covers, stage placement with supply abutment, routability ranking); prepare_layout.py: diffusion segments and breaks, gates driven by stage outputs, pins only on inputs, output pin on its drain landing, routing channels, li1+met1 router (met1 only in multi-stage cells, or a recorded last resort), retries over net orders and placements; rules diff_space, mcon_space, met1_width, met1_space added and proven by pdk_rules.py; tests/specs removed (now generated) | `make layout` for all 18 requests; `make -k drc lvs compare sim model`, results in the session summary | (uncommitted) |
| U2 | 2026-10-30 | Youssef | Claude Code, Claude Opus 5.5 | Quine-McCluskey minimization, decomposition into stages of at most 3 series transistors, fewest inverters, schematic picture and SPICE | Added qm.py, synthesize.py, schematic_plot.py, the Table 6 requests, `make network`; generalized switch_level_check.py to multi-stage networks (more general, on the user's request to build multi-stage cells, AGENTS.md rule 9) with a new multi-stage broken case | `make network`: all 18 requests pass the switch-level check; old and new broken cases rejected; `make test` | (uncommitted) |
| U1 | 2026-10-30 | Youssef, Yara | Claude Code, Claude Opus 5.5 | Write AGENTS.md (used as CLAUDE.md), review src/ against it, run the whole flow and fix bugs | Restructured the repo (code in src/, inputs in tests/, outputs in cells/ and results/); added rules.json + pdk_rules.py, verify_lvs.py, netgen.sh, the Makefile targets and broken cases; generalized the switch, transistor and model checks to the request's truth table (check scripts changed on the user's explicit request, AGENTS.md rule 9) | `make check`, `make test` (whole flow plus every broken case); regenerated GDS byte-identical to the previous commit | (uncommitted) |
