Yara-5/DD2_Project_1/cells/dd2_g5__maj4_1/network_schematic.png

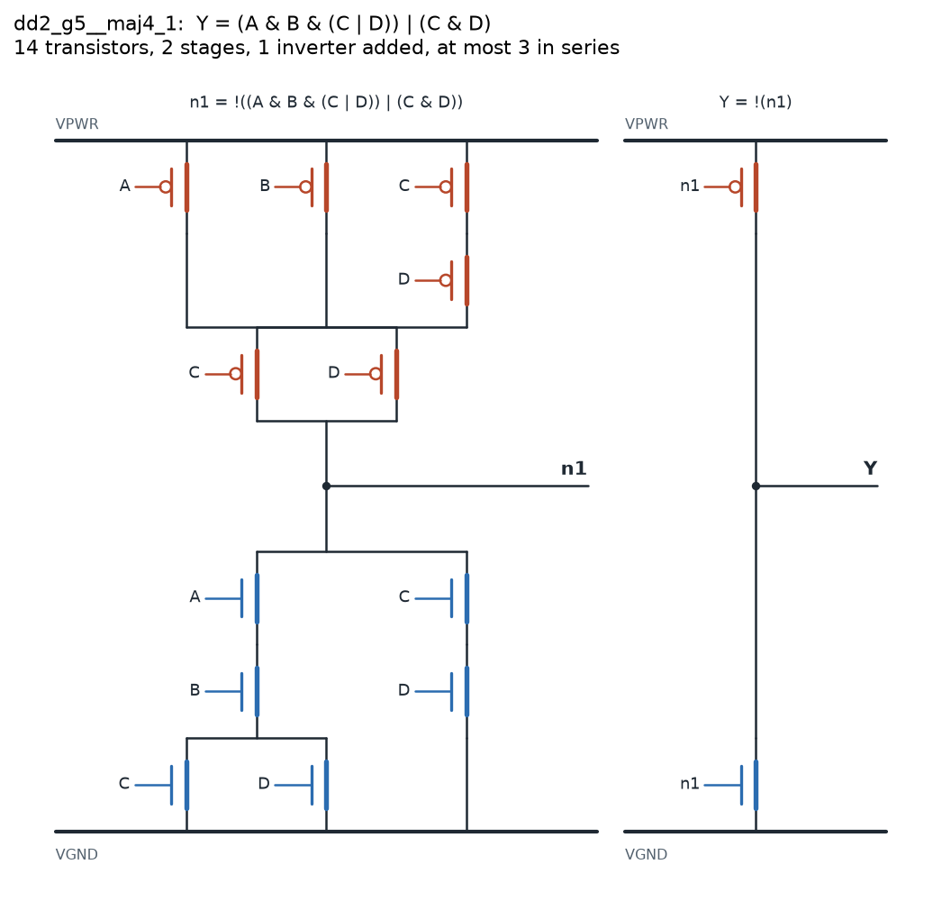
cells/dd2_g5__maj4_1/network_schematic.png
