Yara-5/DD2_Project_1/cells/dd2_g5__nand2_1/network_schematic.png

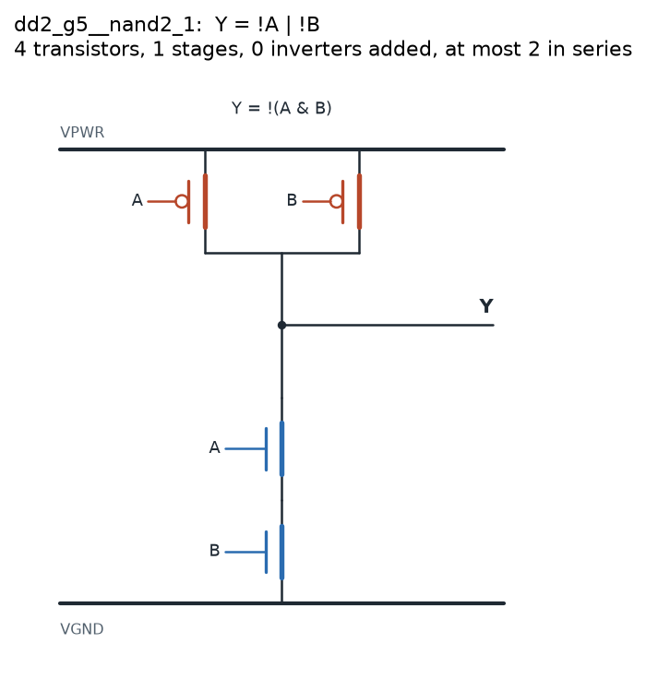
cells/dd2_g5__nand2_1/network_schematic.png
