Yara-5/DD2_Project_1/cells/dd2_g5__nand3_1/network_tree.png

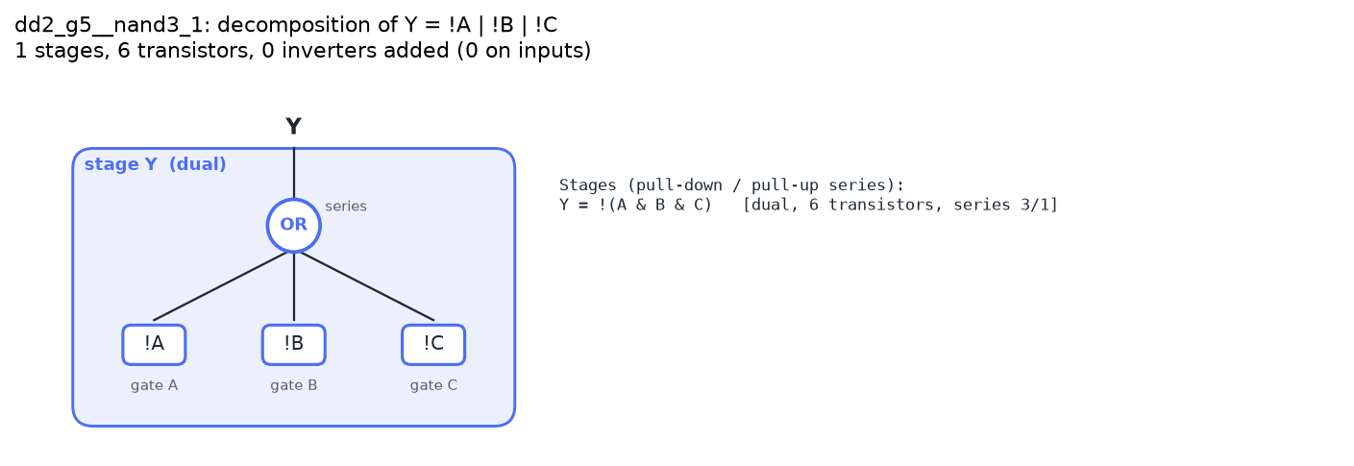
cells/dd2_g5__nand3_1/network_tree.png
