Yara-5/DD2_Project_1/cells/dd2_g5__a21o_1/characterized.pex.spice

* NGSPICE file created from dd2_g5__a21o_1.ext - technology: sky130A

.subckt dd2_g5__a21o_1 A1 A2 B1 VGND VNB VPB VPWR X
X0 VPWR.t0 B1.t1 a_65_297.t1 VPB.t1 sky130_fd_pr__pfet_01v8_hvt ad=0.165 pd=1.33 as=0.165 ps=1.33 w=1 l=0.15
X1 X.t1 a_147_297.t5 VPWR.t1 VPB.t3 sky130_fd_pr__pfet_01v8_hvt ad=0.26 pd=2.52 as=0.165 ps=1.33 w=1 l=0.15
X2 a_147_297.t3 A2.t0 a_147_47.t1 VNB.t3 sky130_fd_pr__nfet_01v8 ad=0.10725 pd=0.98 as=0.08775 ps=0.92 w=0.65 l=0.15
X3 a_65_297.t2 A2.t1 a_147_297.t2 VPB.t2 sky130_fd_pr__pfet_01v8_hvt ad=0.165 pd=1.33 as=0.135 ps=1.27 w=1 l=0.15
X4 a_147_47.t0 A1.t0 VGND.t0 VNB.t0 sky130_fd_pr__nfet_01v8 ad=0.08775 pd=0.92 as=0.169 ps=1.82 w=0.65 l=0.15
X5 a_147_297.t0 A1.t1 a_65_297.t0 VPB.t0 sky130_fd_pr__pfet_01v8_hvt ad=0.135 pd=1.27 as=0.26 ps=2.52 w=1 l=0.15
X6 X.t0 a_147_297.t4 VGND.t2 VNB.t1 sky130_fd_pr__nfet_01v8 ad=0.169 pd=1.82 as=0.10725 ps=0.98 w=0.65 l=0.15
X7 VGND.t1 B1.t0 a_147_297.t1 VNB.t2 sky130_fd_pr__nfet_01v8 ad=0.10725 pd=0.98 as=0.10725 ps=0.98 w=0.65 l=0.15
R0 VGND.n2 VGND.n1 205.666
R1 VGND.n0 VGND.t0 149.762
R2 VGND.n1 VGND.t1 30.462
R3 VGND.n1 VGND.t2 30.462
R4 VGND.n2 VGND.n0 13.0657
R5 VGND.n4 VGND.n3 9.3005
R6 VGND VGND.n4 6.77697
R7 VGND.n4 VGND.n0 4.14168
R8 VGND.n0 VGND 3.10353
R9 VGND.n3 VGND.n2 0.327965
R10 VGND.n3 VGND 0.0239375
R11 X.n0 X.t1 389.846
R12 X.n0 X.t0 209.923
R13 X.n1 X 6.4005
R14 X X.n1 3.2005
R15 X.n1 X.n0 0.213833
R16 VPWR.n1 VPWR.n0 333.575
R17 VPWR.n0 VPWR.t1 32.5055
R18 VPWR.n0 VPWR.t0 32.5055
R19 VPWR VPWR.n1 14.3483
R20 VPWR.n1 VPWR 0.0801404
R21 B1.n0 B1.t1 241.536
R22 B1.n0 B1.t0 169.237
R23 B1 B1.n0 155.103
R24 A2.n0 A2.t1 241.536
R25 A2.n0 A2.t0 169.237
R26 A2 A2.n0 155.103
R27 A1.n0 A1.t1 241.536
R28 A1.n0 A1.t0 169.237
R29 A1 A1.n0 155.103
R30 VPB VPB.t0 307.788
R31 VPB.t1 VPB.t3 284.113
R32 VPB.t2 VPB.t1 284.113
R33 VPB.t0 VPB.t2 248.599
R34 VNB VNB.t0 1480.91
R35 VNB.t2 VNB.t1 1366.99
R36 VNB.t3 VNB.t2 1366.99
R37 VNB.t0 VNB.t3 1196.12
R38 a_147_47.t0 a_147_47.t1 49.8467
R39 a_65_297.t0 a_65_297.n0 565.193
R40 a_65_297.n0 a_65_297.t1 32.5055
R41 a_65_297.n0 a_65_297.t2 32.5055
R42 a_147_297.n3 a_147_297.n2 682.167
R43 a_147_297.n2 a_147_297.n0 248.284
R44 a_147_297.n1 a_147_297.t5 241.536
R45 a_147_297.n1 a_147_297.t4 169.237
R46 a_147_297.n2 a_147_297.n1 152
R47 a_147_297.n0 a_147_297.t1 30.462
R48 a_147_297.n0 a_147_297.t3 30.462
R49 a_147_297.n3 a_147_297.t2 26.5955
R50 a_147_297.t0 a_147_297.n3 26.5955
C0 A2 B1 0.03636f
C1 VPWR B1 0.01972f
C2 A2 VPB 0.02591f
C3 VPB VPWR 0.0899f
C4 VGND X 0.02257f
C5 X B1 0.00134f
C6 A2 A1 0.03922f
C7 A1 VPWR 0.00929f
C8 VPB X 0.0164f
C9 A1 X 0
C10 VGND B1 0.01676f
C11 A2 VPWR 0.00971f
C12 VGND VPB 0.01565f
C13 VPB B1 0.0268f
C14 A2 X 0
C15 VGND A1 0.02809f
C16 X VPWR 0.03264f
C17 A1 VPB 0.0308f
C18 VGND A2 0.02116f
C19 VGND VPWR 0.0311f
C20 VGND VNB 0.40554f
C21 X VNB 0.06766f
C22 VPWR VNB 0.4045f
C23 B1 VNB 0.07806f
C24 A2 VNB 0.07593f
C25 A1 VNB 0.11017f
C26 VPB VNB 0.65408f
C27 a_147_297.t2 VNB 0.04582f
C28 a_147_297.t1 VNB 0.03656f
C29 a_147_297.t3 VNB 0.03444f
C30 a_147_297.n0 VNB 0.03759f
C31 a_147_297.n1 VNB 0.04174f
C32 a_147_297.n2 VNB 0.13469f
C33 a_147_297.n3 VNB 0.0429f
C34 a_147_297.t0 VNB 0.04032f
C35 a_65_297.t1 VNB 0.04652f
C36 a_65_297.t2 VNB 0.04359f
C37 a_65_297.n0 VNB 0.07962f
C38 a_65_297.t0 VNB 0.13182f
C39 a_147_47.t1 VNB 0.02941f
C40 a_147_47.t0 VNB 0.02544f
C41 VPB.t3 VNB 0.09612f
C42 VPB.t1 VNB 0.04012f
C43 VPB.t2 VNB 0.03761f
C44 VPB.t0 VNB 0.03928f
C45 A1.n0 VNB 0.04407f
C46 A2.n0 VNB 0.05514f
C47 B1.n0 VNB 0.06104f
C48 VPWR.t1 VNB 0.03371f
C49 VPWR.t0 VNB 0.04318f
C50 VPWR.n0 VNB 0.02868f
C51 VPWR.n1 VNB 0.18585f
C52 X.t1 VNB 0.06954f
C53 X.t0 VNB 0.04182f
C54 X.n0 VNB 0.05108f
C55 X.n1 VNB 0.00555f
C56 VGND.t0 VNB 0.03072f
C57 VGND.n0 VNB 0.03089f
C58 VGND.t2 VNB 0.02006f
C59 VGND.t1 VNB 0.02691f
C60 VGND.n1 VNB 0.01139f
C61 VGND.n2 VNB 0.07966f
C62 VGND.n3 VNB 0.07592f
C63 VGND.n4 VNB 0.00115f
.ends
