Yara-5/DD2_Project_1/cells/dd2_g5__a21o_opt_1/schematic.spice

* Intended schematic from supplied transistor connections.
* SKY130 model files use um-scale W/L convention; load the course model setup.
.subckt dd2_g5__a21o_opt_1 A B C VGND VNB VPB VPWR Y
XN1 n1_d1 A VGND VNB sky130_fd_pr__nfet_01v8 w=0.65 l=0.15
XN2 n1 B n1_d1 VNB sky130_fd_pr__nfet_01v8 w=0.65 l=0.15
XN3 n1 C VGND VNB sky130_fd_pr__nfet_01v8 w=0.65 l=0.15
XP1 n1_u1 A n1 VPB sky130_fd_pr__pfet_01v8_hvt w=0.98 l=0.15
XP2 n1_u1 B n1 VPB sky130_fd_pr__pfet_01v8_hvt w=0.98 l=0.15
XP3 VPWR C n1_u1 VPB sky130_fd_pr__pfet_01v8_hvt w=0.98 l=0.15
XN4 Y n1 VGND VNB sky130_fd_pr__nfet_01v8 w=0.65 l=0.15
XP4 VPWR n1 Y VPB sky130_fd_pr__pfet_01v8_hvt w=1 l=0.15
.ends dd2_g5__a21o_opt_1
