Yara-5/DD2_Project_1/cells/dd2_g5__a22oi_stack_1/schematic.spice

* Intended schematic from supplied transistor connections.
* SKY130 model files use um-scale W/L convention; load the course model setup.
.subckt dd2_g5__a22oi_stack_1 A B C D VGND VNB VPB VPWR Y
XN1_f1 Y_d1 A VGND VNB sky130_fd_pr__nfet_01v8 w=0.65 l=0.15
XN1_f2 Y_d1 A VGND VNB sky130_fd_pr__nfet_01v8 w=0.65 l=0.15
XN2_f1 Y B Y_d1 VNB sky130_fd_pr__nfet_01v8 w=0.65 l=0.15
XN2_f2 Y B Y_d1 VNB sky130_fd_pr__nfet_01v8 w=0.65 l=0.15
XN3_f1 Y C Y_d2 VNB sky130_fd_pr__nfet_01v8 w=0.65 l=0.15
XN3_f2 Y C Y_d2 VNB sky130_fd_pr__nfet_01v8 w=0.65 l=0.15
XN4_f1 Y_d2 D VGND VNB sky130_fd_pr__nfet_01v8 w=0.65 l=0.15
XN4_f2 Y_d2 D VGND VNB sky130_fd_pr__nfet_01v8 w=0.65 l=0.15
XP1_f1 VPWR A Y_u1 VPB sky130_fd_pr__pfet_01v8_hvt w=1 l=0.15
XP1_f2 VPWR A Y_u1 VPB sky130_fd_pr__pfet_01v8_hvt w=1 l=0.15
XP2_f1 VPWR B Y_u1 VPB sky130_fd_pr__pfet_01v8_hvt w=1 l=0.15
XP2_f2 VPWR B Y_u1 VPB sky130_fd_pr__pfet_01v8_hvt w=1 l=0.15
XP3_f1 Y_u1 C Y VPB sky130_fd_pr__pfet_01v8_hvt w=1 l=0.15
XP3_f2 Y_u1 C Y VPB sky130_fd_pr__pfet_01v8_hvt w=1 l=0.15
XP4_f1 Y_u1 D Y VPB sky130_fd_pr__pfet_01v8_hvt w=1 l=0.15
XP4_f2 Y_u1 D Y VPB sky130_fd_pr__pfet_01v8_hvt w=1 l=0.15
.ends dd2_g5__a22oi_stack_1
