Yara-5/DD2_Project_1/cells/dd2_g5__and2_1/characterized.pex.spice

* NGSPICE file created from dd2_g5__and2_1.ext - technology: sky130A

.subckt dd2_g5__and2_1 A B VGND VNB VPB VPWR Y
X0 VGND.t0 A.t0 a_149_47.t0 VNB.t1 sky130_fd_pr__nfet_01v8 ad=0.10725 pd=0.98 as=0.08775 ps=0.92 w=0.65 l=0.15
X1 a_149_47.t1 B.t0 a_67_47.t2 VNB.t2 sky130_fd_pr__nfet_01v8 ad=0.08775 pd=0.92 as=0.169 ps=1.82 w=0.65 l=0.15
X2 Y.t1 a_67_47.t4 VPWR.t2 VPB.t2 sky130_fd_pr__pfet_01v8_hvt ad=0.26 pd=2.52 as=0.165 ps=1.33 w=1 l=0.15
X3 Y.t0 a_67_47.t3 VGND.t1 VNB.t0 sky130_fd_pr__nfet_01v8 ad=0.169 pd=1.82 as=0.10725 ps=0.98 w=0.65 l=0.15
X4 VPWR.t1 A.t1 a_67_47.t0 VPB.t0 sky130_fd_pr__pfet_01v8_hvt ad=0.165 pd=1.33 as=0.135 ps=1.27 w=1 l=0.15
X5 a_67_47.t1 B.t1 VPWR.t0 VPB.t1 sky130_fd_pr__pfet_01v8_hvt ad=0.135 pd=1.27 as=0.26 ps=2.52 w=1 l=0.15
R0 VGND.n1 VGND.n0 116.132
R1 VGND.n0 VGND.t1 30.462
R2 VGND.n0 VGND.t0 30.462
R3 VGND VGND.n1 14.1864
R4 VGND.n1 VGND 0.240312
R5 Y.n0 Y.t1 389.846
R6 Y.n0 Y.t0 209.923
R7 Y.n1 Y 6.4005
R8 Y Y.n1 3.2005
R9 Y.n1 Y.n0 0.213833
R10 VPWR.n0 VPWR.t0 347.57
R11 VPWR.n2 VPWR.n1 332.353
R12 VPWR.n1 VPWR.t1 32.5055
R13 VPWR.n1 VPWR.t2 32.5055
R14 VPWR.n2 VPWR.n0 23.9894
R15 VPWR.n4 VPWR.n0 17.3181
R16 VPWR.n4 VPWR.n3 9.3005
R17 VPWR VPWR.n4 6.77697
R18 VPWR.n3 VPWR.n2 1.07665
R19 VPWR.n3 VPWR 0.0239375
R20 A.n0 A.t1 241.536
R21 A.n0 A.t0 169.237
R22 A A.n0 155.103
R23 B.n0 B.t1 241.536
R24 B.n0 B.t0 169.237
R25 B B.n0 155.103
R26 VPB VPB.t1 313.707
R27 VPB.t0 VPB.t2 284.113
R28 VPB.t1 VPB.t0 248.599
R29 VNB VNB.t2 1509.39
R30 VNB.t1 VNB.t0 1366.99
R31 VNB.t2 VNB.t1 1196.12
R32 a_149_47.t0 a_149_47.t1 49.8467
R33 a_67_47.n0 a_67_47.t4 241.536
R34 a_67_47.n1 a_67_47.t2 232.464
R35 a_67_47.n2 a_67_47.n1 204.118
R36 a_67_47.n1 a_67_47.n0 201.582
R37 a_67_47.n0 a_67_47.t3 169.237
R38 a_67_47.t0 a_67_47.n2 26.5955
R39 a_67_47.n2 a_67_47.t1 26.5955
C0 VGND B 0.01666f
C1 VPWR B 0.01954f
C2 Y B 0
C3 VPB B 0.03068f
C4 VPWR VGND 0.02717f
C5 A B 0.03922f
C6 VGND Y 0.03406f
C7 VGND VPB 0.01324f
C8 VPWR Y 0.03264f
C9 A VGND 0.02435f
C10 VPWR VPB 0.09203f
C11 VPWR A 0.01882f
C12 Y VPB 0.01594f
C13 A Y 0.0012f
C14 A VPB 0.02588f
C15 VGND VNB 0.43107f
C16 Y VNB 0.06805f
C17 VPWR VNB 0.28914f
C18 A VNB 0.07673f
C19 B VNB 0.10128f
C20 VPB VNB 0.56672f
C21 a_67_47.t2 VNB 0.08711f
C22 a_67_47.n0 VNB 0.04742f
C23 a_67_47.n1 VNB 0.19109f
C24 a_67_47.t1 VNB 0.04397f
C25 a_67_47.n2 VNB 0.03812f
C26 a_67_47.t0 VNB 0.04639f
C27 a_149_47.t1 VNB 0.02934f
C28 a_149_47.t0 VNB 0.0311f
C29 VPB.t2 VNB 0.09855f
C30 VPB.t0 VNB 0.03823f
C31 VPB.t1 VNB 0.04035f
C32 B.n0 VNB 0.05339f
C33 A.n0 VNB 0.05828f
C34 VPWR.t0 VNB 0.06234f
C35 VPWR.n0 VNB 0.02787f
C36 VPWR.t2 VNB 0.03135f
C37 VPWR.t1 VNB 0.04057f
C38 VPWR.n1 VNB 0.02564f
C39 VPWR.n2 VNB 0.05694f
C40 VPWR.n3 VNB 0.14156f
C41 VPWR.n4 VNB 0.00383f
C42 Y.t1 VNB 0.068f
C43 Y.t0 VNB 0.04078f
C44 Y.n0 VNB 0.05064f
C45 Y.n1 VNB 0.0055f
C46 VGND.t1 VNB 0.0199f
C47 VGND.t0 VNB 0.02657f
C48 VGND.n0 VNB 0.01661f
C49 VGND.n1 VNB 0.06645f
.ends
