Yara-5/DD2_Project_1/cells/dd2_g5__maj4_1/characterized.pex.spice

* NGSPICE file created from dd2_g5__maj4_1.ext - technology: sky130A

.subckt dd2_g5__maj4_1 A B C D VGND VNB VPB VPWR Y
X0 a_237_47.t0 C.t1 a_153_47.t0 VNB.t0 sky130_fd_pr__nfet_01v8 ad=0.10725 pd=0.98 as=0.08775 ps=0.92 w=0.65 l=0.15
X1 a_237_47.t1 C.t2 a_525_297.t0 VPB.t1 sky130_fd_pr__pfet_01v8_hvt ad=0.26 pd=2.52 as=0.135 ps=1.27 w=1 l=0.15
X2 a_71_297.t3 A.t1 a_237_47.t2 VPB.t5 sky130_fd_pr__pfet_01v8_hvt ad=0.165 pd=1.33 as=0.165 ps=1.33 w=1 l=0.15
X3 a_525_297.t1 D.t2 a_71_297.t2 VPB.t3 sky130_fd_pr__pfet_01v8_hvt ad=0.135 pd=1.27 as=0.165 ps=1.33 w=1 l=0.15
X4 VGND.t3 D.t0 a_429_47.t1 VNB.t3 sky130_fd_pr__nfet_01v8 ad=0.08775 pd=0.92 as=0.10725 ps=0.98 w=0.65 l=0.15
X5 a_429_47.t2 A.t0 a_333_47.t0 VNB.t5 sky130_fd_pr__nfet_01v8 ad=0.10725 pd=0.98 as=0.10725 ps=0.98 w=0.65 l=0.15
X6 a_237_47.t4 B.t1 a_71_297.t4 VPB.t6 sky130_fd_pr__pfet_01v8_hvt ad=0.165 pd=1.33 as=0.165 ps=1.33 w=1 l=0.15
X7 Y.t1 a_237_47.t6 VPWR.t2 VPB.t4 sky130_fd_pr__pfet_01v8_hvt ad=0.26 pd=2.52 as=0.26 ps=2.52 w=1 l=0.15
X8 a_71_297.t0 C.t3 VPWR.t0 VPB.t0 sky130_fd_pr__pfet_01v8_hvt ad=0.165 pd=1.33 as=0.135 ps=1.27 w=1 l=0.15
X9 a_429_47.t0 C.t0 VGND.t0 VNB.t1 sky130_fd_pr__nfet_01v8 ad=0.169 pd=1.82 as=0.08775 ps=0.92 w=0.65 l=0.15
X10 VPWR.t1 D.t3 a_71_297.t1 VPB.t2 sky130_fd_pr__pfet_01v8_hvt ad=0.135 pd=1.27 as=0.26 ps=2.52 w=1 l=0.15
X11 a_153_47.t1 D.t1 VGND.t2 VNB.t2 sky130_fd_pr__nfet_01v8 ad=0.08775 pd=0.92 as=0.169 ps=1.82 w=0.65 l=0.15
X12 Y.t0 a_237_47.t5 VGND.t1 VNB.t4 sky130_fd_pr__nfet_01v8 ad=0.169 pd=1.82 as=0.169 ps=1.82 w=0.65 l=0.15
X13 a_333_47.t1 B.t0 a_237_47.t3 VNB.t6 sky130_fd_pr__nfet_01v8 ad=0.10725 pd=0.98 as=0.10725 ps=0.98 w=0.65 l=0.15
R0 VGND.n0 VGND.t2 282.817
R1 VGND.n5 VGND.n4 199.739
R2 VGND.n3 VGND.t1 155.357
R3 VGND.n12 VGND.n11 34.6358
R4 VGND.n11 VGND.n10 34.6358
R5 VGND.n10 VGND.n2 34.6358
R6 VGND.n6 VGND.n2 34.6358
R7 VGND.n4 VGND.t3 24.9236
R8 VGND.n4 VGND.t0 24.9236
R9 VGND.n5 VGND.n3 11.7301
R10 VGND.n7 VGND.n6 9.3005
R11 VGND.n8 VGND.n2 9.3005
R12 VGND.n10 VGND.n9 9.3005
R13 VGND.n11 VGND.n1 9.3005
R14 VGND.n13 VGND.n12 9.3005
R15 VGND.n15 VGND.n14 9.3005
R16 VGND VGND.n15 6.77697
R17 VGND.n15 VGND.n0 6.4005
R18 VGND.n6 VGND.n5 4.89462
R19 VGND.n12 VGND.n0 3.38874
R20 VGND.n7 VGND.n3 0.86083
R21 VGND.n14 VGND.n13 0.120292
R22 VGND.n13 VGND.n1 0.120292
R23 VGND.n9 VGND.n1 0.120292
R24 VGND.n9 VGND.n8 0.120292
R25 VGND.n8 VGND.n7 0.120292
R26 VGND.n14 VGND 0.0239375
R27 Y.n0 Y.t1 389.846
R28 Y.n0 Y.t0 209.923
R29 Y.n1 Y 6.4005
R30 Y Y.n1 3.2005
R31 Y.n1 Y.n0 0.213833
R32 VPWR.n2 VPWR.n1 607.212
R33 VPWR.n3 VPWR.t2 354.49
R34 VPWR.n6 VPWR.n0 34.6358
R35 VPWR.n1 VPWR.t1 26.5955
R36 VPWR.n1 VPWR.t0 26.5955
R37 VPWR.n3 VPWR.n2 26.4239
R38 VPWR.n2 VPWR.n0 15.8123
R39 VPWR.n6 VPWR.n5 9.3005
R40 VPWR.n4 VPWR.n0 9.3005
R41 VPWR VPWR.n6 6.77697
R42 VPWR.n4 VPWR.n3 0.147983
R43 VPWR.n5 VPWR.n4 0.120292
R44 VPWR.n5 VPWR 0.0239375
R45 A.n0 A.t1 241.536
R46 A.n0 A.t0 169.237
R47 A A.n0 155.103
R48 B.n0 B.t1 241.536
R49 B.n0 B.t0 169.237
R50 B B.n0 155.103
R51 C.n1 C.t3 241.536
R52 C.n0 C.t2 241.536
R53 C.n2 C.n0 172.45
R54 C.n1 C.t1 169.237
R55 C.n0 C.t0 169.237
R56 C.n2 C.n1 152
R57 C C.n2 3.10353
R58 D.n1 D.t3 241.536
R59 D.n0 D.t2 241.536
R60 D.n2 D.n0 172.45
R61 D.n1 D.t1 169.237
R62 D.n0 D.t0 169.237
R63 D.n2 D.n1 152
R64 D D.n2 3.10353
R65 VPB.t1 VPB.t4 556.386
R66 VPB VPB.t2 325.546
R67 VPB.t5 VPB.t3 284.113
R68 VPB.t6 VPB.t5 284.113
R69 VPB.t0 VPB.t6 284.113
R70 VPB.t3 VPB.t1 248.599
R71 VPB.t2 VPB.t0 248.599
R72 VNB.t1 VNB.t4 2677.02
R73 VNB VNB.t2 1566.34
R74 VNB.t5 VNB.t3 1366.99
R75 VNB.t6 VNB.t5 1366.99
R76 VNB.t0 VNB.t6 1366.99
R77 VNB.t3 VNB.t1 1196.12
R78 VNB.t2 VNB.t0 1196.12
R79 a_429_47.t0 a_429_47.n0 455.611
R80 a_429_47.n0 a_429_47.t1 30.462
R81 a_429_47.n0 a_429_47.t2 30.462
R82 a_333_47.t0 a_333_47.t1 60.9236
R83 a_153_47.t0 a_153_47.t1 49.8467
R84 a_525_297.t0 a_525_297.t1 53.1905
R85 a_71_297.n1 a_71_297.n0 356.096
R86 a_71_297.n1 a_71_297.t1 281.969
R87 a_71_297.n2 a_71_297.n1 189.28
R88 a_71_297.n0 a_71_297.t2 32.5055
R89 a_71_297.n0 a_71_297.t3 32.5055
R90 a_71_297.n2 a_71_297.t4 32.5055
R91 a_71_297.t0 a_71_297.n2 32.5055
R92 a_237_47.n2 a_237_47.n1 585
R93 a_237_47.n3 a_237_47.t6 241.536
R94 a_237_47.t1 a_237_47.n4 228.411
R95 a_237_47.n4 a_237_47.n3 210.617
R96 a_237_47.n2 a_237_47.n0 187.857
R97 a_237_47.n3 a_237_47.t5 169.237
R98 a_237_47.n4 a_237_47.n2 89.224
R99 a_237_47.n1 a_237_47.t4 32.5055
R100 a_237_47.n1 a_237_47.t2 32.5055
R101 a_237_47.n0 a_237_47.t0 30.462
R102 a_237_47.n0 a_237_47.t3 30.462
C0 VPWR B 0.00702f
C1 VPB A 0.02683f
C2 VGND C 0.03561f
C3 Y A 0
C4 D A 0.05056f
C5 Y VPB 0.01499f
C6 VGND B 0.01348f
C7 D VPB 0.05912f
C8 C A 0.01156f
C9 VPB C 0.06846f
C10 D Y 0
C11 B A 0.03636f
C12 Y C 0.00171f
C13 VPB B 0.02683f
C14 D C 0.1923f
C15 VPWR VGND 0.01998f
C16 Y B 0
C17 D B 0.01131f
C18 B C 0.05028f
C19 VPWR A 0.00703f
C20 VPWR VPB 0.13573f
C21 VPWR Y 0.0319f
C22 VGND A 0.01457f
C23 VPWR D 0.02446f
C24 VGND VPB 0.01483f
C25 VPWR C 0.04832f
C26 VGND Y 0.03528f
C27 D VGND 0.09223f
C28 VGND VNB 0.58516f
C29 Y VNB 0.07135f
C30 VPWR VNB 0.45713f
C31 A VNB 0.07858f
C32 B VNB 0.07832f
C33 C VNB 0.15203f
C34 D VNB 0.17659f
C35 VPB VNB 1.01297f
C36 a_237_47.t3 VNB 0.04032f
C37 a_237_47.t0 VNB 0.04462f
C38 a_237_47.n0 VNB 0.1045f
C39 a_237_47.t2 VNB 0.05903f
C40 a_237_47.t4 VNB 0.0587f
C41 a_237_47.n1 VNB 0.05807f
C42 a_237_47.n2 VNB 0.28132f
C43 a_237_47.n3 VNB 0.067f
C44 a_237_47.n4 VNB 0.20256f
C45 a_237_47.t1 VNB 0.12214f
C46 a_71_297.t4 VNB 0.05056f
C47 a_71_297.t2 VNB 0.05532f
C48 a_71_297.t3 VNB 0.05089f
C49 a_71_297.n0 VNB 0.0533f
C50 a_71_297.t1 VNB 0.11541f
C51 a_71_297.n1 VNB 0.21056f
C52 a_71_297.n2 VNB 0.04179f
C53 a_71_297.t0 VNB 0.05651f
C54 a_525_297.t1 VNB 0.05115f
C55 a_525_297.t0 VNB 0.05233f
C56 a_153_47.t1 VNB 0.0345f
C57 a_153_47.t0 VNB 0.03536f
C58 a_333_47.t1 VNB 0.03432f
C59 a_333_47.t0 VNB 0.03456f
C60 a_429_47.t1 VNB 0.03959f
C61 a_429_47.t2 VNB 0.03638f
C62 a_429_47.n0 VNB 0.06514f
C63 a_429_47.t0 VNB 0.10021f
C64 VPB.t4 VNB 0.12009f
C65 VPB.t1 VNB 0.06049f
C66 VPB.t3 VNB 0.04003f
C67 VPB.t5 VNB 0.0427f
C68 VPB.t6 VNB 0.0427f
C69 VPB.t0 VNB 0.04003f
C70 VPB.t2 VNB 0.04314f
C71 D.n0 VNB 0.08536f
C72 D.n1 VNB 0.06893f
C73 D.n2 VNB 0.25325f
C74 C.n0 VNB 0.0883f
C75 C.n1 VNB 0.07131f
C76 C.n2 VNB 0.26198f
C77 B.n0 VNB 0.05971f
C78 A.n0 VNB 0.06038f
C79 VPWR.n0 VNB 0.00901f
C80 VPWR.t0 VNB 0.04629f
C81 VPWR.t1 VNB 0.0451f
C82 VPWR.n1 VNB 0.02166f
C83 VPWR.n2 VNB 0.02177f
C84 VPWR.t2 VNB 0.06955f
C85 VPWR.n3 VNB 0.3932f
C86 VPWR.n4 VNB 0.04438f
C87 VPWR.n5 VNB 0.02088f
C88 VPWR.n6 VNB 0.00739f
C89 Y.t1 VNB 0.07599f
C90 Y.t0 VNB 0.04641f
C91 Y.n0 VNB 0.05152f
C92 Y.n1 VNB 0.0056f
C93 VGND.t2 VNB 0.04197f
C94 VGND.n0 VNB 0.02256f
C95 VGND.n1 VNB 0.02421f
C96 VGND.n2 VNB 0.00857f
C97 VGND.t1 VNB 0.03854f
C98 VGND.n3 VNB 0.06167f
C99 VGND.t0 VNB 0.03056f
C100 VGND.t3 VNB 0.0297f
C101 VGND.n4 VNB 0.01035f
C102 VGND.n5 VNB 0.0234f
C103 VGND.n6 VNB 0.00489f
C104 VGND.n7 VNB 0.11243f
C105 VGND.n8 VNB 0.02421f
C106 VGND.n9 VNB 0.02421f
C107 VGND.n10 VNB 0.00857f
C108 VGND.n11 VNB 0.00857f
C109 VGND.n12 VNB 0.00471f
C110 VGND.n13 VNB 0.02421f
C111 VGND.n14 VNB 0.01447f
C112 VGND.n15 VNB 0.00163f
.ends
