Yara-5/DD2_Project_1/cells/dd2_g5__mux2_1/characterized.pex.spice

* NGSPICE file created from dd2_g5__mux2_1.ext - technology: sky130A

.subckt dd2_g5__mux2_1 A0 A1 S VGND VNB VPB VPWR X
X0 X.t3 a_127_47.t3 a_233_297.t1 VPB.t2 sky130_fd_pr__pfet_01v8_hvt ad=0.155 pd=1.31 as=0.26 ps=2.52 w=1 l=0.15
X1 a_501_199.t2 S.t0 VGND.t2 VNB.t5 sky130_fd_pr__nfet_01v8 ad=0.17225 pd=1.18 as=0.17875 ps=1.2 w=0.65 l=0.15
X2 a_127_47.t0 A1.t1 VPWR.t0 VPB.t0 sky130_fd_pr__pfet_01v8_hvt ad=0.26 pd=2.52 as=0.26 ps=2.52 w=1 l=0.15
X3 VGND.t1 A0.t0 a_501_199.t0 VNB.t3 sky130_fd_pr__nfet_01v8 ad=0.169 pd=1.82 as=0.17225 ps=1.18 w=0.65 l=0.15
X4 a_683_297.t1 S.t2 VPWR.t2 VPB.t5 sky130_fd_pr__pfet_01v8_hvt ad=0.265 pd=1.53 as=0.275 ps=1.55 w=1 l=0.15
X5 a_501_199.t1 A0.t1 a_683_297.t0 VPB.t3 sky130_fd_pr__pfet_01v8_hvt ad=0.26 pd=2.52 as=0.265 ps=1.53 w=1 l=0.15
X6 a_233_297.t2 S.t3 X.t0 VPB.t4 sky130_fd_pr__pfet_01v8_hvt ad=0.265 pd=1.53 as=0.155 ps=1.31 w=1 l=0.15
X7 a_127_47.t1 A1.t0 VGND.t0 VNB.t0 sky130_fd_pr__nfet_01v8 ad=0.169 pd=1.82 as=0.169 ps=1.82 w=0.65 l=0.15
X8 a_315_47.t0 a_127_47.t2 VGND.t3 VNB.t1 sky130_fd_pr__nfet_01v8 ad=0.10075 pd=0.96 as=0.169 ps=1.82 w=0.65 l=0.15
X9 VPWR.t1 a_501_199.t4 a_233_297.t0 VPB.t1 sky130_fd_pr__pfet_01v8_hvt ad=0.275 pd=1.55 as=0.265 ps=1.53 w=1 l=0.15
X10 VGND.t4 a_501_199.t3 X.t2 VNB.t2 sky130_fd_pr__nfet_01v8 ad=0.17875 pd=1.2 as=0.17225 ps=1.18 w=0.65 l=0.15
X11 X.t1 S.t1 a_315_47.t1 VNB.t4 sky130_fd_pr__nfet_01v8 ad=0.17225 pd=1.18 as=0.10075 ps=0.96 w=0.65 l=0.15
R0 VGND.n10 VGND.t3 282.817
R1 VGND.n4 VGND.n3 199.739
R2 VGND.n5 VGND.t1 156.154
R3 VGND.n14 VGND.t0 149.762
R4 VGND.n3 VGND.t4 50.7697
R5 VGND.n3 VGND.t2 50.7697
R6 VGND.n9 VGND.n8 34.6358
R7 VGND.n8 VGND.n2 34.6358
R8 VGND.n10 VGND.n0 32.7534
R9 VGND.n4 VGND.n2 22.2123
R10 VGND.n14 VGND.n0 13.177
R11 VGND.n10 VGND.n9 11.6711
R12 VGND.n12 VGND.n0 9.3005
R13 VGND.n11 VGND.n10 9.3005
R14 VGND.n9 VGND.n1 9.3005
R15 VGND.n8 VGND.n7 9.3005
R16 VGND.n6 VGND.n2 9.3005
R17 VGND.n14 VGND.n13 9.3005
R18 VGND.n5 VGND.n4 6.93613
R19 VGND.n14 VGND 5.53564
R20 VGND VGND.n14 3.10353
R21 VGND.n6 VGND.n5 0.280421
R22 VGND.n13 VGND.n12 0.120292
R23 VGND.n12 VGND.n11 0.120292
R24 VGND.n11 VGND.n1 0.120292
R25 VGND.n7 VGND.n1 0.120292
R26 VGND.n7 VGND.n6 0.120292
R27 VGND.n13 VGND 0.0239375
R28 X X.n1 686.611
R29 X X.n0 191.024
R30 X.n0 X.t2 48.9236
R31 X.n0 X.t1 48.9236
R32 X.n1 X.t0 30.5355
R33 X.n1 X.t3 30.5355
R34 VPWR.n2 VPWR.n1 327.969
R35 VPWR VPWR.t0 257.096
R36 VPWR.n1 VPWR.t1 54.1755
R37 VPWR.n1 VPWR.t2 54.1755
R38 VPWR.n2 VPWR.n0 33.1997
R39 VPWR.n4 VPWR.n3 9.3005
R40 VPWR.n4 VPWR.n0 9.03579
R41 VPWR VPWR.n4 6.77697
R42 VPWR.n0 VPWR 0.376971
R43 VPWR.n3 VPWR.n2 0.148621
R44 VPWR.n3 VPWR 0.0239375
R45 A0.n0 A0.t1 241.536
R46 A0.n0 A0.t0 169.237
R47 A0 A0.n0 155.103
R48 S.n2 S.n0 285.497
R49 S.n1 S.t3 241.536
R50 S.n0 S.t2 241.536
R51 S.n1 S.t1 169.237
R52 S.n0 S.t0 169.237
R53 S.n2 S.n1 152
R54 S S.n2 4.0965
R55 A1.n0 A1.t1 241.536
R56 A1.n0 A1.t0 169.237
R57 A1 A1.n0 155.103
R58 VPB.t0 VPB.t2 556.386
R59 VPB.t1 VPB.t5 414.33
R60 VPB.t5 VPB.t3 402.493
R61 VPB.t4 VPB.t1 402.493
R62 VPB.t2 VPB.t4 272.274
R63 VPB VPB.t0 248.599
R64 VNB.t0 VNB.t1 2677.02
R65 VNB.t2 VNB.t5 1993.53
R66 VNB.t5 VNB.t3 1936.57
R67 VNB.t4 VNB.t2 1936.57
R68 VNB.t1 VNB.t4 1310.03
R69 VNB VNB.t0 1196.12
R70 a_315_47.t0 a_315_47.t1 57.2313
R71 a_683_297.t0 a_683_297.t1 104.41
R72 a_233_297.n0 a_233_297.t1 669.317
R73 a_233_297.t0 a_233_297.n0 52.2055
R74 a_233_297.n0 a_233_297.t2 52.2055
R75 a_501_199.t1 a_501_199.n2 310.717
R76 a_501_199.n2 a_501_199.n0 243.107
R77 a_501_199.n0 a_501_199.t4 241.536
R78 a_501_199.n0 a_501_199.t3 169.237
R79 a_501_199.n2 a_501_199.n1 95.685
R80 a_501_199.n1 a_501_199.t0 48.9236
R81 a_501_199.n1 a_501_199.t2 48.9236
R82 a_127_47.t0 a_127_47.n1 262.193
R83 a_127_47.n0 a_127_47.t3 229.754
R84 a_127_47.n1 a_127_47.t1 229.536
R85 a_127_47.n1 a_127_47.n0 165.577
R86 a_127_47.n0 a_127_47.t2 157.453
C0 X A0 0
C1 S VPB 0.0721f
C2 S VGND 0.03602f
C3 X VPB 0.00869f
C4 X VGND 0.05327f
C5 VPWR A0 0.01352f
C6 VPWR VPB 0.14312f
C7 X S 0.06038f
C8 VPWR VGND 0.05695f
C9 VPWR A1 0.02324f
C10 VPWR S 0.06526f
C11 A0 VPB 0.03362f
C12 VPWR X 0.01053f
C13 VGND A0 0.02546f
C14 VGND VPB 0.01661f
C15 A1 VPB 0.03542f
C16 A1 VGND 0.02653f
C17 S A0 0.01429f
C18 VGND VNB 0.6119f
C19 X VNB 0.09217f
C20 VPWR VNB 0.51192f
C21 A0 VNB 0.1161f
C22 S VNB 0.14159f
C23 A1 VNB 0.11763f
C24 VPB VNB 1.00534f
C25 a_127_47.t1 VNB 0.05587f
C26 a_127_47.n0 VNB 0.05531f
C27 a_127_47.n1 VNB 0.14507f
C28 a_127_47.t0 VNB 0.09276f
C29 a_501_199.n0 VNB 0.05098f
C30 a_501_199.t0 VNB 0.03721f
C31 a_501_199.t2 VNB 0.04041f
C32 a_501_199.n1 VNB 0.04404f
C33 a_501_199.n2 VNB 0.1869f
C34 a_501_199.t1 VNB 0.10965f
C35 a_233_297.t1 VNB 0.1113f
C36 a_233_297.t2 VNB 0.05255f
C37 a_233_297.n0 VNB 0.10018f
C38 a_233_297.t0 VNB 0.04506f
C39 a_683_297.t1 VNB 0.0538f
C40 a_683_297.t0 VNB 0.04936f
C41 a_315_47.t1 VNB 0.02889f
C42 a_315_47.t0 VNB 0.02327f
C43 VPB.t3 VNB 0.09496f
C44 VPB.t5 VNB 0.05903f
C45 VPB.t1 VNB 0.05903f
C46 VPB.t4 VNB 0.04876f
C47 VPB.t2 VNB 0.05988f
C48 VPB.t0 VNB 0.05817f
C49 A1.n0 VNB 0.04357f
C50 S.n0 VNB 0.08515f
C51 S.n1 VNB 0.05286f
C52 S.n2 VNB 0.12334f
C53 A0.n0 VNB 0.04422f
C54 VPWR.t0 VNB 0.06008f
C55 VPWR.n0 VNB 0.0086f
C56 VPWR.t2 VNB 0.04645f
C57 VPWR.t1 VNB 0.03896f
C58 VPWR.n1 VNB 0.04271f
C59 VPWR.n2 VNB 0.39497f
C60 VPWR.n3 VNB 0.02963f
C61 VPWR.n4 VNB 0.0026f
C62 X.t2 VNB 0.03333f
C63 X.t1 VNB 0.03874f
C64 X.n0 VNB 0.03966f
C65 X.t0 VNB 0.04409f
C66 X.t3 VNB 0.03636f
C67 X.n1 VNB 0.04166f
C68 VGND.n0 VNB 0.00491f
C69 VGND.t0 VNB 0.03079f
C70 VGND.n1 VNB 0.0209f
C71 VGND.n2 VNB 0.00607f
C72 VGND.t1 VNB 0.03255f
C73 VGND.t2 VNB 0.02755f
C74 VGND.t4 VNB 0.02213f
C75 VGND.n3 VNB 0.01755f
C76 VGND.n4 VNB 0.02286f
C77 VGND.n5 VNB 0.08417f
C78 VGND.n6 VNB 0.06143f
C79 VGND.n7 VNB 0.0209f
C80 VGND.n8 VNB 0.0074f
C81 VGND.n9 VNB 0.00495f
C82 VGND.t3 VNB 0.02822f
C83 VGND.n10 VNB 0.02318f
C84 VGND.n11 VNB 0.0209f
C85 VGND.n12 VNB 0.0209f
C86 VGND.n13 VNB 0.01249f
C87 VGND.n14 VNB 0.03084f
.ends
