Yara-5/DD2_Project_1/cells/dd2_g5__nand3_1/characterized.pex.spice

* NGSPICE file created from dd2_g5__nand3_1.ext - technology: sky130A

.subckt dd2_g5__nand3_1 A B C VGND VNB VPB VPWR Y
X0 VPWR.t0 C.t1 Y.t0 VPB.t1 sky130_fd_pr__pfet_01v8_hvt ad=0.26 pd=2.52 as=0.155 ps=1.31 w=1 l=0.15
X1 VPWR.t1 A.t1 Y.t1 VPB.t0 sky130_fd_pr__pfet_01v8_hvt ad=0.135 pd=1.27 as=0.26 ps=2.52 w=1 l=0.15
X2 a_195_47.t1 B.t0 a_111_47.t1 VNB.t2 sky130_fd_pr__nfet_01v8 ad=0.10075 pd=0.96 as=0.08775 ps=0.92 w=0.65 l=0.15
X3 a_111_47.t0 A.t0 Y.t3 VNB.t0 sky130_fd_pr__nfet_01v8 ad=0.08775 pd=0.92 as=0.169 ps=1.82 w=0.65 l=0.15
X4 Y.t2 B.t1 VPWR.t2 VPB.t2 sky130_fd_pr__pfet_01v8_hvt ad=0.155 pd=1.31 as=0.135 ps=1.27 w=1 l=0.15
X5 VGND.t0 C.t0 a_195_47.t0 VNB.t1 sky130_fd_pr__nfet_01v8 ad=0.169 pd=1.82 as=0.10075 ps=0.96 w=0.65 l=0.15
R0 VGND.n0 VGND.t0 289.916
R1 VGND VGND.n0 14.302
R2 VGND.n0 VGND 0.125759
R3 VPWR.n2 VPWR.t0 356.716
R4 VPWR.n1 VPWR.n0 320.976
R5 VPWR.n4 VPWR.n1 34.6358
R6 VPWR.n0 VPWR.t1 26.5955
R7 VPWR.n0 VPWR.t2 26.5955
R8 VPWR.n4 VPWR.n3 9.3005
R9 VPWR.n2 VPWR.n1 7.21807
R10 VPWR VPWR.n4 6.77697
R11 VPWR.n3 VPWR.n2 0.531936
R12 VPWR.n3 VPWR 0.0239375
R13 Y.n1 Y.t1 285.897
R14 Y.n1 Y.n0 201.595
R15 Y.n2 Y.t3 131.941
R16 Y.n2 Y.n1 122.422
R17 Y.n0 Y.t0 30.5355
R18 Y.n0 Y.t2 30.5355
R19 Y Y.n2 3.05545
R20 C.n0 C.t1 230.155
R21 C.n0 C.t0 157.856
R22 C C.n0 155.103
R23 B.n0 B.t1 241.536
R24 B.n0 B.t0 169.237
R25 B B.n0 155.103
R26 A.n0 A.t1 241.536
R27 A.n0 A.t0 169.237
R28 A A.n0 155.103
R29 VPB.t2 VPB.t1 272.274
R30 VPB.t0 VPB.t2 248.599
R31 VPB VPB.t0 201.246
R32 VNB.t2 VNB.t1 1310.03
R33 VNB.t0 VNB.t2 1196.12
R34 VNB VNB.t0 968.285
R35 a_195_47.t0 a_195_47.t1 57.2313
R36 a_111_47.t0 a_111_47.t1 49.8467
C0 VGND VPB 0.00672f
C1 A VPB 0.02938f
C2 B Y 0.06399f
C3 C B 0.02424f
C4 B VPWR 0.02013f
C5 VGND Y 0.05998f
C6 C VGND 0.02624f
C7 VGND VPWR 0.02393f
C8 Y A 0.04905f
C9 A VPWR 0.0178f
C10 Y VPB 0.02042f
C11 C VPB 0.03813f
C12 VPB VPWR 0.05876f
C13 B VGND 0.01326f
C14 B A 0.03922f
C15 B VPB 0.02563f
C16 C Y 0.03727f
C17 Y VPWR 0.15159f
C18 C VPWR 0.0287f
C19 VGND A 0.01159f
C20 VGND VNB 0.33547f
C21 VPWR VNB 0.25128f
C22 Y VNB 0.1349f
C23 C VNB 0.12935f
C24 B VNB 0.07768f
C25 A VNB 0.11295f
C26 VPB VNB 0.46789f
C27 a_111_47.t1 VNB 0.03037f
C28 a_111_47.t0 VNB 0.02576f
C29 a_195_47.t1 VNB 0.03134f
C30 a_195_47.t0 VNB 0.02545f
C31 VPB.t1 VNB 0.07258f
C32 VPB.t2 VNB 0.03548f
C33 VPB.t0 VNB 0.03064f
C34 A.n0 VNB 0.04787f
C35 B.n0 VNB 0.06072f
C36 C.n0 VNB 0.06247f
C37 Y.t0 VNB 0.03883f
C38 Y.t2 VNB 0.04694f
C39 Y.n0 VNB 0.03552f
C40 Y.t1 VNB 0.09278f
C41 Y.n1 VNB 0.16129f
C42 Y.t3 VNB 0.04617f
C43 Y.n2 VNB 0.04563f
C44 VPWR.t2 VNB 0.04039f
C45 VPWR.t1 VNB 0.03401f
C46 VPWR.n0 VNB 0.02195f
C47 VPWR.n1 VNB 0.03251f
C48 VPWR.t0 VNB 0.0615f
C49 VPWR.n2 VNB 0.06711f
C50 VPWR.n3 VNB 0.09592f
C51 VPWR.n4 VNB 0.00708f
C52 VGND.t0 VNB 0.03295f
C53 VGND.n0 VNB 0.06919f
.ends
