Yara-5/DD2_Project_1/cells/dd2_g5__nor2_stack_1/schematic.spice

* Intended schematic from supplied transistor connections.
* SKY130 model files use um-scale W/L convention; load the course model setup.
.subckt dd2_g5__nor2_stack_1 A B VGND VNB VPB VPWR Y
XN1 Y A VGND VNB sky130_fd_pr__nfet_01v8 w=0.65 l=0.15
XN2 Y B VGND VNB sky130_fd_pr__nfet_01v8 w=0.65 l=0.15
XP1_f1 VPWR A Y_u1 VPB sky130_fd_pr__pfet_01v8_hvt w=1 l=0.15
XP1_f2 VPWR A Y_u1 VPB sky130_fd_pr__pfet_01v8_hvt w=1 l=0.15
XP2_f1 Y_u1 B Y VPB sky130_fd_pr__pfet_01v8_hvt w=1 l=0.15
XP2_f2 Y_u1 B Y VPB sky130_fd_pr__pfet_01v8_hvt w=1 l=0.15
.ends dd2_g5__nor2_stack_1
